Michalek007/CurrentSensingCircuit/Dokumentacja/schematics/LPF.tex

\begin{subfigure}{\textwidth}
    \hspace{4.5cm}
    \begin{tikzpicture}
        \draw
            (0, 0) node[op amp](amp1){}
            (amp1.up) to[short, -o] ++ (0, 0.5) node[above]{$3.3\ V$}
            (amp1.down) node[ground]{}

            (amp1.out) |-  ++ (0, 3) to[R, l=$R_2$, a=$100\ k\Omega$] ++ (-2, 0) -| (amp1.-)
            (amp1.out) ++ (-2.38, 3) to[R, l=$R_3$, a=$10k$, *-] ++ (-2, 0) node[ground]{}
            
            (amp1.+) to[short, -o] ++ (-1, 0) node[above]{$V_{IN}$}
            % (amp1.out) to[short, *-o] ++ (1, 0) node[above]{$V_{CMOUT}$}
            (amp1.out) to[R, l=$R_1$, a=$50\ \Omega$, *-] ++ (2, 0) coordinate(Vout) to[short, *-o] ++ (3, 0) node[above]{$V_{OUT}$}
            (Vout) to[C, l=$C_1$, a=$10\ nF$] ++ (0, -2) node[ground]{}
            (Vout) ++ (2, 0) to[R, l=$R_4$, a=$510$, *-] ++ (0, -2) node[ground]{}
        ;
    \end{tikzpicture}
\end{subfigure}
