Michalek007/CurrentSensingCircuit/Dokumentacja/schematics/wzmacniacz_pomiarowy.tex

\begin{subfigure}{\textwidth}
    \hspace{3cm}
    \begin{tikzpicture}
        \draw
            (0, 0) node[op amp, scale = 2](amp){} node[]{INA333}
            (amp) ++ (-1.66, -0.5) -- ++ (-1.22, 0) to[/tikz/circuitikz/bipoles/length=30pt, R, l=$R_G$, a=$1\ k\Omega$] ++ (0, 1) -- ++ (1.22, 0)
            (amp.up) to[short, -o] ++ (0, 0.5) node[above]{$3.3\ V$}
            (amp.down) node[ground]{}
            (amp.+) -- ++ (-2.75, 0) to[R, l=$R_{meas}$, a=$100\ \Omega$] ++ (0, 1.96)
            (amp.-) -- ++ (-2.75, 0)
            (amp.+) ++ (-2.75, 0) to[short, *-o] ++ (0, -0.5) node[below]{$In_+$}
            (amp.-) ++ (-2.75, 0) to[short, *-o] ++ (0, 0.5) node[above]{$In_-$}
            % (amp.+) ++ (-2.75, 0) to[short, *-o] ++ (-0.5, 0) node[left]{$V_{CM}$}

            (amp) ++ (1, -0.4) to[short, -o] ++ (0, -1) node[below]{$V_{REF+N}$}
            (amp.out) to[short, -o] ++ (1, 0) node[above]{$V_{out}$}

            % (amp.+) ++ (-1, -2) node[below]{$V_{REF+N}$} to[R, o-*, l=$R_1$, a=$10\ M\Omega$] ++ (0, 2) 
        ;
    \end{tikzpicture}
\end{subfigure}
