Michalek007/CurrentSensingCircuit/Dokumentacja/schematics/PSU.tex

\begin{subfigure}{\textwidth}
    \hspace{4cm}
    \begin{tikzpicture}
    \draw
        (0, 0) node[draw, rectangle, minimum width = 3cm, minimum height = 2cm, label = {above:LT1117-3.3}](U1){}
        (U1.west) node[right=1mm] {IN}
        (U1.east) node[left=1mm] {OUT}
        (U1.south) node[above=1mm] {GND}
        (U1.south) node[ground]{}

        (U1.west) -- ++(-2,0) coordinate(IN)
        to[C, l=$C_{1}$, a=$10\ \mu$F] (IN |- U1.south) node[ground] {}
        (IN) to[short, *-o] ++ (-1, 0) node[above]{$5V$}

        (U1.east) -- ++(2,0) coordinate(OUT)
        to[C, l=$C_{2}$, a=$100\ \mu$F] (OUT |- U1.south) node[ground] {}
        (OUT) to[short, *-o] ++ (1, 0) node[above]{$3.3V$}

        ;
    \end{tikzpicture}
\end{subfigure}
