Michalek007/CurrentSensingCircuit/Dokumentacja/schematics/BlockDiagramFinal.tex

\begin{subfigure}{\textwidth}
    \hspace{0cm}
    \begin{tikzpicture}
        \draw
            (0, 0) node[op amp](amp1){}
            (0, -3) node[draw, rectangle, minimum width = 2cm, minimum height = 2cm, label = {[align = center]center:$V_{REF}$ and \\ noise gen}](REF){}
            % (3, -3) node[draw, rectangle, minimum width = 2cm, minimum height = 2cm, label = {[align = center]center:Noise \\Gen}]{}
            % (5.5, -1) node[adder] (add) {}
            (4.5, 0) node[draw, rectangle, minimum width = 2cm, minimum height = 2cm, label = {[align = center]center:LPF}](LPF){}
            (9, 0) node[draw, rectangle, minimum width = 3cm, minimum height = 5cm, label = {[align = center]center:MCU}](MCU){}
            (9, -5) node[draw, rectangle, minimum width = 2cm, minimum height = 2cm, label = {[align = center]center:USB}](USB){}
            (4, -5) node[draw, rectangle, minimum width = 2cm, minimum height = 2cm, label = {[align = center]center:PSU}](PSU){}
            % (add.135) ++ (-1, 1) -- ++ (0.5, 0) -- (add)
            % (add.225) ++ (-1.15, -1) -- ++ (0.5, 0) -- (add) 
            % (add) -- ++ (1, 0)

            (amp1) ++ (0.3, -0.3) -- ++ (0, -1.7)
            (LPF) ++ (-1, 0) -- (amp1.out)
            (amp1.+) -- ++ (-1, 0) to[/tikz/circuitikz/bipoles/length=20pt, R, l=$R_{meas}$] ++ (0, 1)
            (amp1.-) -- ++ (-1, 0) to[short, *-o] ++ (0, 1) node[above]{$in-$}
            (amp1.+) ++ (-1, 0) to[short, *-o] ++ (0, -1) node[below]{$in+$}
            (LPF) ++ (1, 0) -- ++ (2, 0) ++ (-0.75, 0) node[above]{$ADC_{in}$}
            (USB) ++ (0.5, 1) -- ++ (0, 1.5) ++ (0, -0.75) node[right]{$D-$}
            (USB) ++ (-0.5, 1) -- ++ (0, 1.5) ++ (0, -0.75) node[left]{$D+$}
            (PSU) ++ (1, 0) -- ++ (3, 0) ++ (-1, 0) node[above]{$+5\ V$}
            (PSU) ++ (-1, 0) to[short, -o] ++ (-1, 0) node[above]{$+3.3\ V$}
        ;
            % wzmacniacz pomiarowy, zrodlo ref, generacja szumu, sumator, MCU, USB, PSU, LPF
    \end{tikzpicture}
\end{subfigure}
