Michalek007/CurrentSensingCircuit/Dokumentacja/schematics/Vref_gen.tex

\begin{subfigure}{\textwidth}
    \hspace{0.5cm}
    \begin{tikzpicture}
        \draw
            (0, 0) node[op amp](amp){}
            (amp.up) to[short, -o] ++ (0, 0.5) node[above]{$3.3\ V$}
            (amp.down) node[ground]{}
            (amp.-) -| ++ (-0.5, 1.5) -| ++ (2.98, -2)
            (amp.out) -- ++ (0.1, 0) to[short, *-o] ++ (1, 0) node[above]{$V_{REF}$}
            % (amp.out) ++ (0.1, -3) node[ground]{} to[C, l=$C_1$, a=$100\ nF$] ++ (0, 2) -- ++ (0, 1)
            (amp.+) -- ++ (-9, 0) ++ (0, -2) node[ground]{} to[C, l=$C_2$, a=$100\ nF$] ++ (0, 2)
            (amp.+) ++ (-6, -2) node[ground]{} to[C, -*, l=$C_3$, a=$1\ \mu F$] ++ (0, 2)
            (amp.+) ++ (-3, -2) node[ground]{} to[R, -*, l=$R_2$, a=$10\ k\Omega$] ++ (0, 2)
            to[R, -o, l=$R_1$, a=$10\ k\Omega$] ++ (0, 2) node[above]{$3.3\ V$}
        ;
    \end{tikzpicture}
\end{subfigure}

% usunac cap ma wyjsciu op-ampa
