Michalek007/CurrentSensingCircuit/Dokumentacja/schematics/Sumator.tex

\begin{subfigure}{\textwidth}
    \hspace{3cm}
    \begin{tikzpicture}
        \draw
            (0, 0) node[op amp, scale = 2](amp){}
            (amp.up) to[short, -o] ++ (0, 0.5) node[above]{$3.3\ V$}
            (amp.down) node[ground]{}
            
            (amp.+) to[R, l=$R_{4}$, a=$1.2\ k\Omega$] ++ (-2, 0) to[short, -o] ++ (0, 0.5) node[above]{$3.3\ V$} 
            (amp.+) ++ (0, -2.5) node[ground]{} to[R, -*, l=$R_{5}$, a=$1k$] ++ (0, 2.5)
            
            (amp.-) to[R, -o, l=$R_{3}$] ++ (-5.2, 0) node[above]{$V_{noise}$}

            (amp.out) to[short, *-] ++ (0, 3) to[R, l=$R_{2}$, a=$10k$] ++ (-5, 0) coordinate(test)
            to[R, l=$R_{1}$, a=$10k$] ++ (-5, 0) to[short, -o] ++ (0, 0) node[above]{$V_{in}$}
            (test) to[short, *-*] ++ (0, -2)
            (amp.out) to[short, -o] ++ (1, 0) node[above]{$V_{out}$}
        ;
    \end{tikzpicture}
\end{subfigure}
