Michalek007/CurrentSensingCircuit/Dokumentacja/chapters/schematy.tex

\section{Schematy ideowe układu}
    \begin{figure}[!ht]
        \centering
        \scalebox{1}{\input{schematics/wzmacniacz_pomiarowy.tex}}
        \caption{Schemat ideowy wzmacniacza pomiarowego.}
        \label{sch:INA333}
    \end{figure}
    \begin{figure}[!ht]
        \centering
        \scalebox{1}{\input{schematics/Vref_noise_gen.tex}}
        \caption{Schemat ideowy źródła napięcia referencyjnego z układem generacji szumu.}
        \label{sch:Vref_gen}
    \end{figure}
    % \begin{figure}[!ht]
    %     \centering
    %     \scalebox{1}{\input{schematics/Vcm_measure.tex}}
    %     \caption{Schemat do pomiaru napięcia sumacyjnego.}
    %     \label{sch:VCM_measure}
    % \end{figure}
    % \clearpage
    \begin{figure}[!ht]
        \centering
        \scalebox{1}{\input{schematics/LPF.tex}}
        \caption{Schemat pasywnego filtru RC o częstotliwości granicznej $f_g \approx 318\ kHz$.}
        \label{sch:LPF}
    \end{figure}
    % \begin{figure}[!ht]
    %     \centering
    %     \scalebox{1}{\input{schematics/Noise_gen.tex}}
    %     \caption{Schemat układu generacji szumu białego.}
    %     \label{sch:Noise_gen}
    % \end{figure}
    % \begin{figure}[!ht]
    %     \centering
    %     \scalebox{1}{\input{schematics/Sumator.tex}}
    %     \caption{Układ sumacyjny dla dodania sygnału pomiarowego i szumu.}
    %     \label{sch:sumator}
    % \end{figure}
    \begin{figure}[!ht]
        \centering
        \scalebox{1}{\input{schematics/PSU.tex}}
        \caption{Układ stabilizacji napięcia na 3.3V. }
        \label{sch:psu}
    \end{figure}
