Michalek007/CurrentSensingCircuit/Dokumentacja/main.pdf

# Akademia Górniczo-Hutnicza im. Stanisława Staszica w Krakowie

# Dokumentacja projektu

# Układ do pomiaru natężenia prądu poniżej jednego LSB przetwornika A/C

z przedmiotu

# Analogowe układy peryferyjne w systemach cyfrowych

Elektronika i telekomunikacja - Systemy wbudowane, rok II studiów magisterskich

### Piotr Kowol, Piotr Mosurek, Michał Nizioł

### 12 listopada 2025

## Spis treści

1 Wstęp | 2
1.1 Założenia | | 2
1.2 Schemat Blokowy | | 2
2 Schematy ideowe układu | 3
3 Symulacje układów | 4

## Spis rysunków

1.1 Schemat blokowy układu do pomiaru natężenia prądu | | 2
2.1 Schemat ideowy wzmacniacza pomiarowego | | 3
2.2 Schemat ideowy źródła napięcia referencyjnego z układem generacji szumu. . . . | 3
2.3 Schemat pasywnego filtru RC o częstotliwości granicznej fg ≈ 318 kHz | | 3
2.4 Układ stabilizacji napięcia na 3.3V | | 3
3.1 Symulacja tran stabilizatora napięcia LM1117-3.3 napięcia wejściowego (Vin) i
wyjściowego (Vout) | | 4
3.2 Symulacja parametryczna wzmacniacza pomiarowego w zakresie ±1 µA | | 5
3.3 Symulacja parametryczna wzmacniacza pomiarowego w zakresie ±100 nA. . . . | 5
3.4 Symulacja dc wejściowego napięcia wspólnego wzmacniacza pomiarowego dla
Imeas = 1 µA, różnica napięć ≈ 65 µV | | 6
3.5 Wzmocnie różnicowe INA333 | | 6
3.6 Wzmocnienie od wejścia REF wzmacniacza pomiarowego | | 7
3.7 Charakterystyki częstotliwościowe układu: czerwona - pasmo przenoszenia generatora szumu, zielona - pasmo przenoszenia na wyjściu INA333, niebieska -pasmo przenoszenia za filtrem LPF z wtórnikiem - UWAGA, bez wtónika jest
podbicie o ≈ 7 dB na wyjściu INA333 przy f ≈ 150 kHz | 7
3.8 Transformata fouriera z 10 ms symulacji transient wzmacniacza pomiarowego z generacją szumu na referencji. Okno fft 100 Hz, co daje ≈ 1.65 √

µV
Hz | 8

## 1. Wstęp

### 1.1. Założenia

| Pomiar prądu rzędu 10 nA,
| Wykorzystanie ditheringu szumem Gaussowskim,
| Wykorzystanie mikroprocesora STM32F103C8T6 z 12 bitowym ADC,
| Wykorzystanie wzmacniacza pomiarowego INA333.

### 1.2. Schemat Blokowy

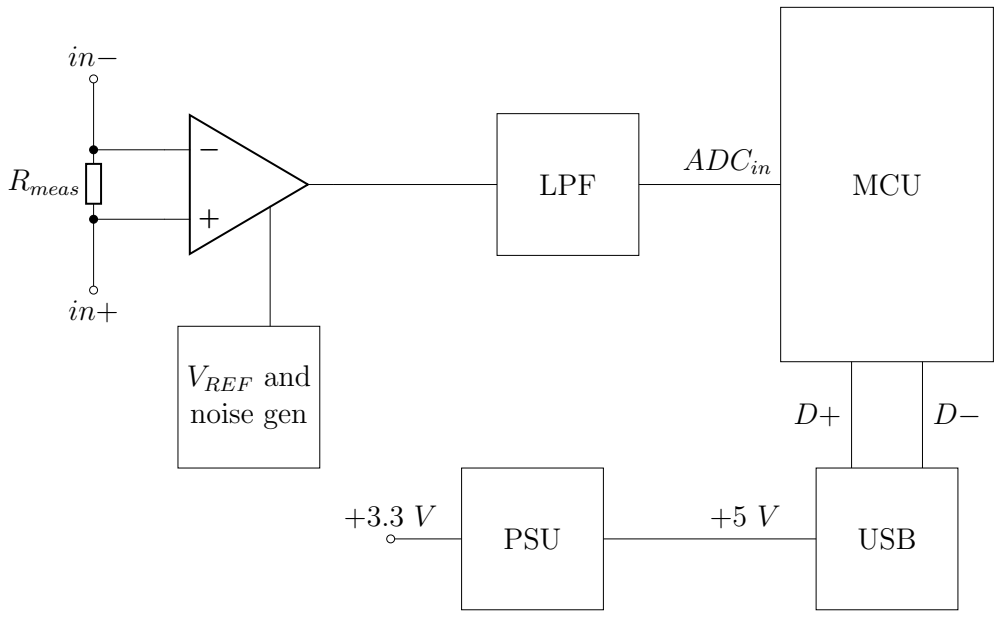
[picture p2: figure]
VREF and noise gen; LPF; MCU; PSU; USB; Rmeas; ADCin

Rysunek 1.1: Schemat blokowy układu do pomiaru natężenia prądu.

## 2. Schematy ideowe układu

−

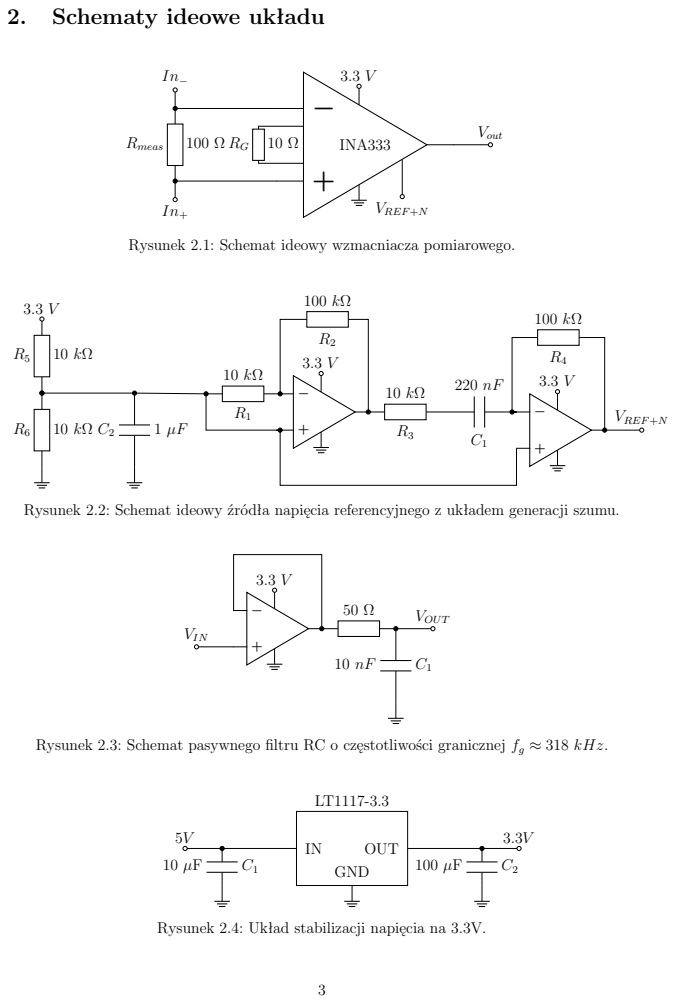
[picture p3: page 4]

Rysunek 2.1: Schemat ideowy wzmacniacza pomiarowego.

Rysunek 2.2: Schemat ideowy źródła napięcia referencyjnego z układem generacji szumu.

Rysunek 2.3: Schemat pasywnego filtru RC o częstotliwości granicznej fg ≈ 318 kHz.

Rysunek 2.4: Układ stabilizacji napięcia na 3.3V.

## 3. Symulacje układów

Podczas symulacji sprawdzono działanie kilku bloków funkcjonalnych, tj. PSU, generator szumu białego oraz wzmacniacz pomiarowy. Symulacja czasowa PSU pozwoliła sprawdzić jak duży będzie przerzut napięcia podczas uruchomiania układu. Wyniki przedstawiono na rysunku 3.1.

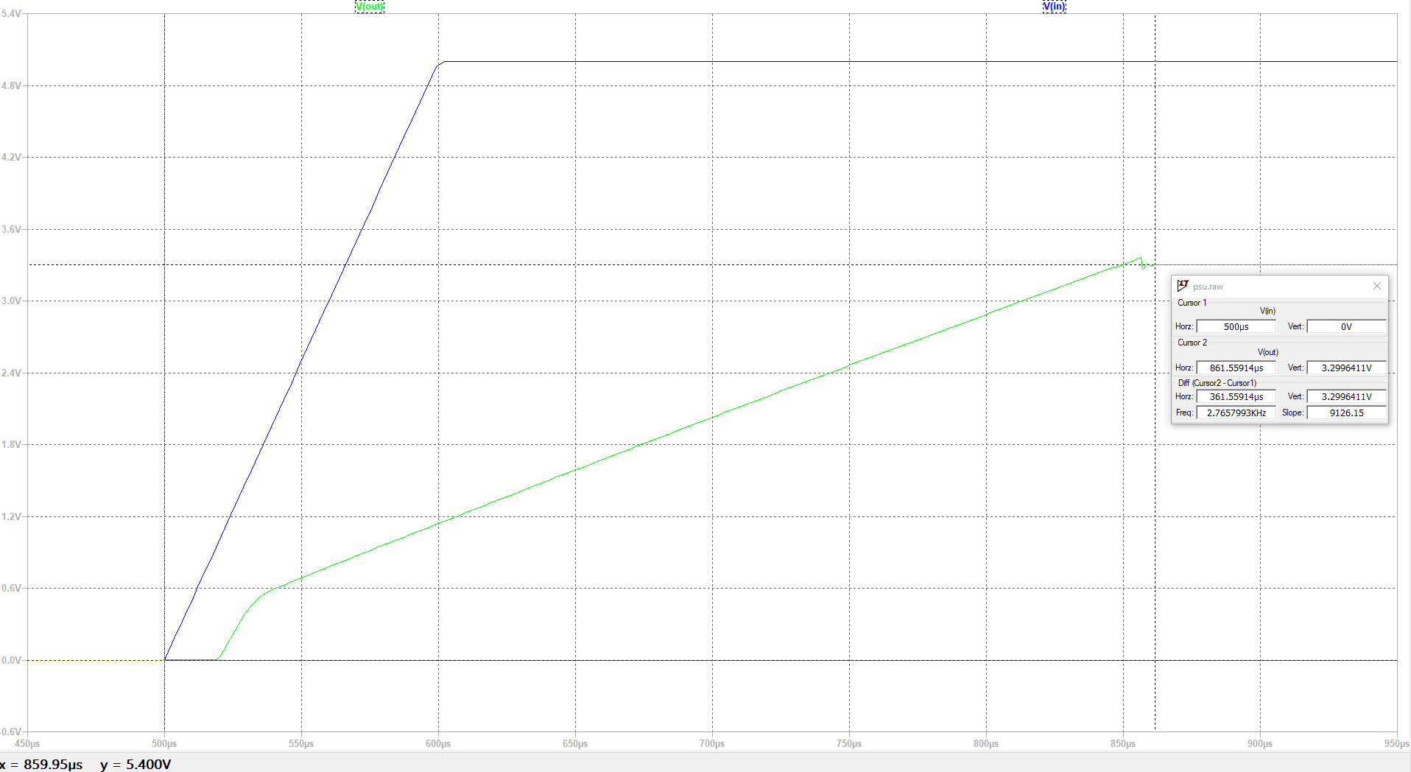
[picture p4: figure]

Rysunek 3.1: Symulacja tran stabilizatora napięcia LM1117-3.3 napięcia wejściowego (Vin) i wyjściowego (Vout).

Podczas symulacji wzmacniacza pomiarowego okazało się, że możliwe będzie zmierzenie prądów o natężeniu 1 nA. Czułość wzmacniacza określono na 1 mV
1 nA . Zakres pomiarowy wynosi ±1 µA, a dopuszczalny zakres napięcia wspólnego, przy maksymalnym prądzie wynosi ≈ 0.7 V ÷ ≈ 2.8 V . Zależność napięcia wyjściowego od prądu wejściowego przedstawiono na wykresach 3.3 i 3.2. Zależność napięcia wyjściowego od wejściowego napięcia wspólnego dla prądu 1 µA została przedstawiona na wykresie 3.4.
parametr | wartość | komentarz
czułość | mV 1 nA | czułość układu bez ditheringu
zakres pomiarowy | ±1 µA | -
zakres napięcia wspólnego | 0.7 ÷ 2.8 V | -
częstotliwość graniczna | 30 Hz | ograniczenie od INA333
pasmo szumu białego | 100 Hz ÷ 200 kHz | górne ograniczenie od wejścia REF INA333
napięcie szumu | ≈ 0.74 mV | w paśmie 100 Hz ÷ 200 kHz
widmowa gęstość szumu | ≈ 1.65 √ µV Hz | -
częstotliwość próbkowania | fS = 1 MHz | z dokumentacji STM32F103C8T6
częstotliwość nadpróbkowania | fOV S = 62.5 kHz | nadpróbkowanie 16 razy
dodatkowe bity | +2 bity | na podstawie AN5537
teoretyczna wartość mierzalnego | Imeas ≈ 250 pA | jeśli nie tracimy na ENOB prądu przy ditheringu

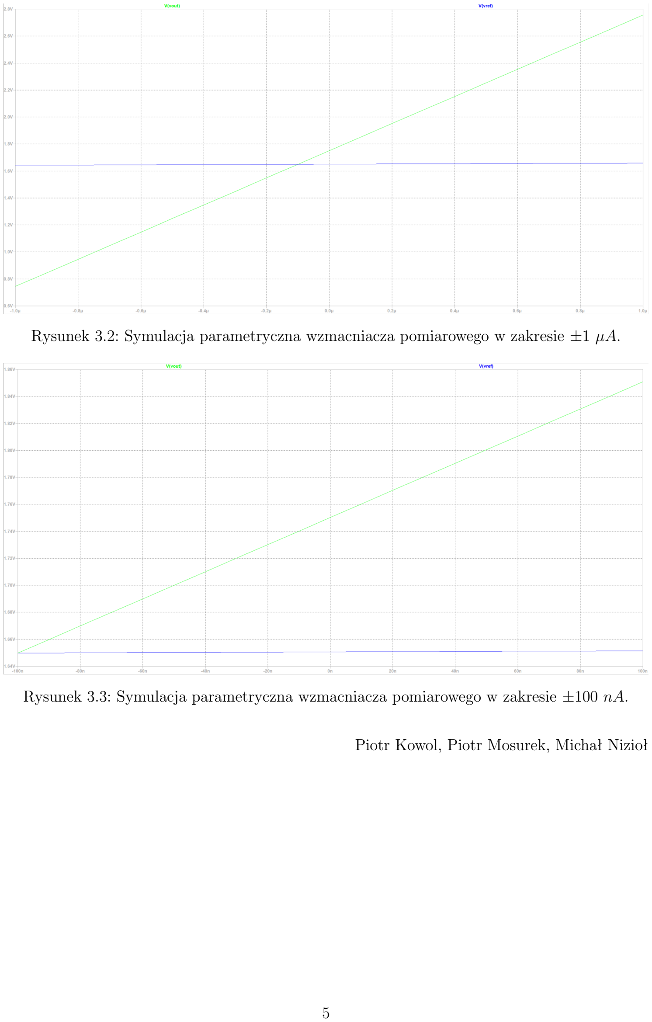
[picture p5: page 6]

Rysunek 3.2: Symulacja parametryczna wzmacniacza pomiarowego w zakresie ±1 µA.

Rysunek 3.3: Symulacja parametryczna wzmacniacza pomiarowego w zakresie ±100 nA.

Piotr Kowol, Piotr Mosurek, Michał Nizioł

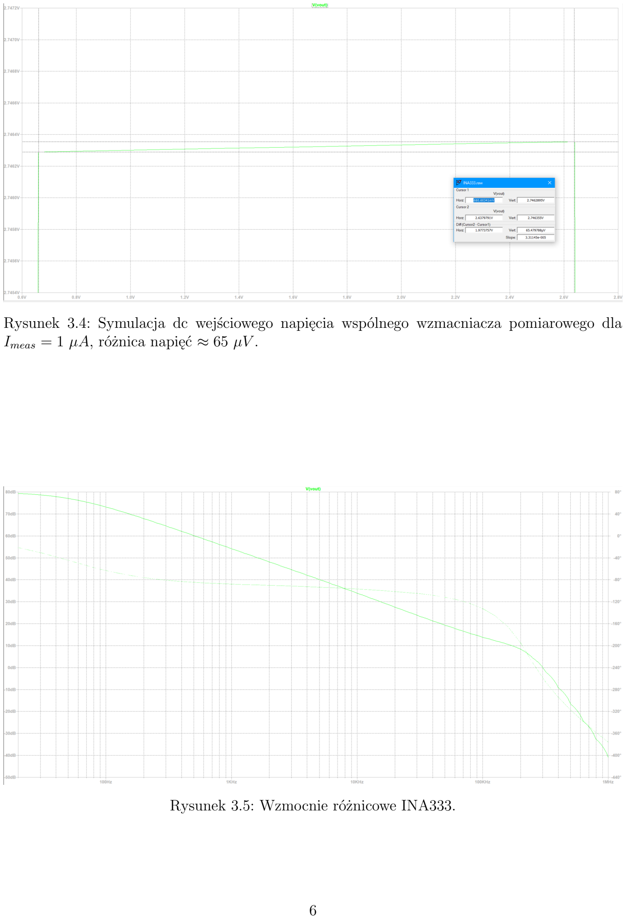
[picture p6: page 7]

Rysunek 3.4: Symulacja dc wejściowego napięcia wspólnego wzmacniacza pomiarowego dla Imeas = 1 µA, różnica napięć ≈ 65 µV .

Rysunek 3.5: Wzmocnie różnicowe INA333.

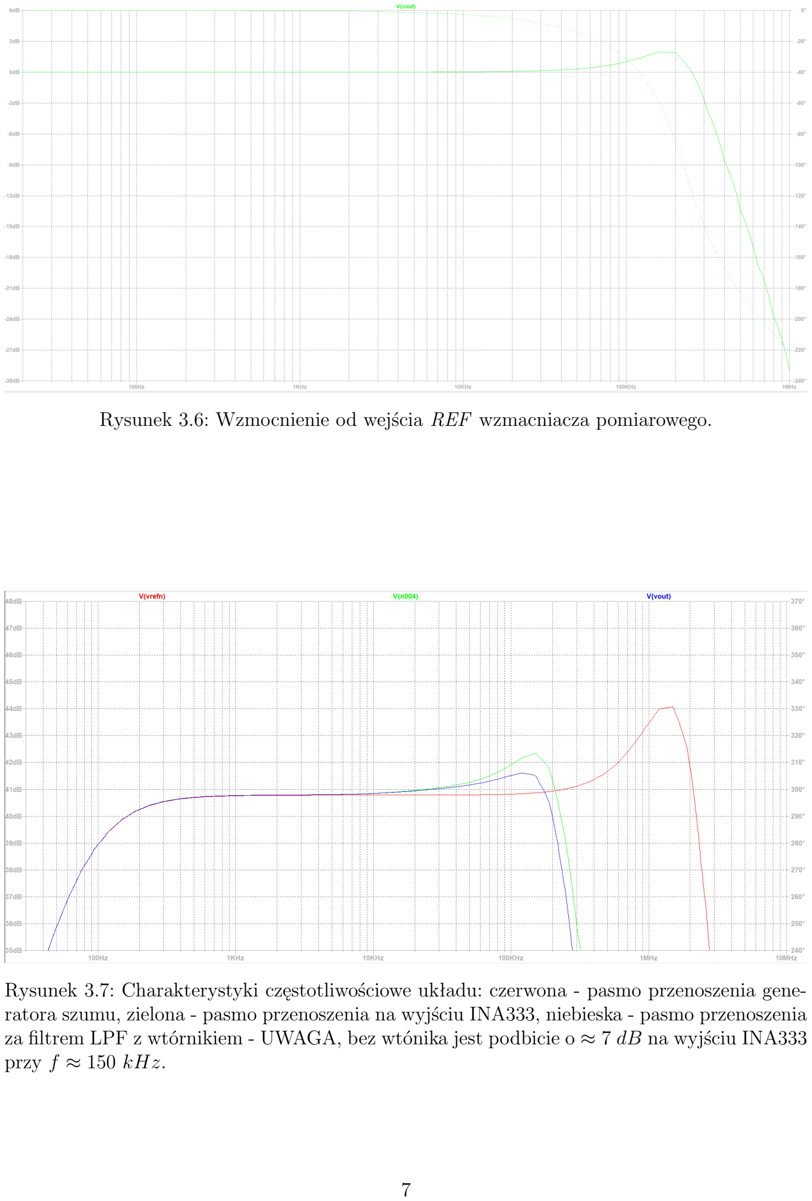
[picture p7: page 8]

Rysunek 3.6: Wzmocnienie od wejścia REF wzmacniacza pomiarowego.

Rysunek 3.7: Charakterystyki częstotliwościowe układu: czerwona - pasmo przenoszenia generatora szumu, zielona - pasmo przenoszenia na wyjściu INA333, niebieska - pasmo przenoszenia za filtrem LPF z wtórnikiem - UWAGA, bez wtónika jest podbicie o ≈ 7 dB na wyjściu INA333 przy f ≈ 150 kHz.

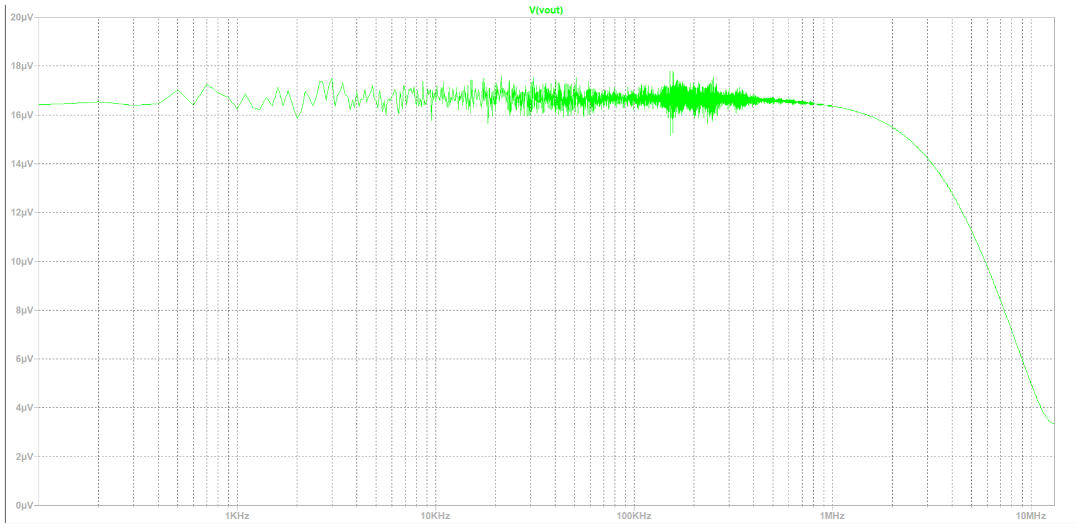
[picture p8: figure]

Rysunek 3.8: Transformata fouriera z 10 ms symulacji transient wzmacniacza pomiarowego z generacją szumu na referencji. Okno fft 100 Hz, co daje ≈ 1.65 √

µV
Hz .
