Michalek007/CurrentSensingCircuit/Raport/main.pdf

# Akademia Górniczo-Hutnicza im. Stanisława Staszica w Krakowie

# Raport z projektu

# Układ do pomiaru natężenia prądu poniżej jednego LSB przetwornika A/C

z przedmiotu

# Analogowe układy peryferyjne w systemach cyfrowych

Elektronika i telekomunikacja - Systemy wbudowane, rok II studiów magisterskich

### Piotr Kowol, Piotr Mosurek, Michał Nizioł

### 19 lutego 2026

## 1. Schematy ideowe układu

Poniżej przedstawiono schematy części analogowej układu. Podczas pomiarów okazało się, że szum INA333 jest znacznie większy od szumu generowanego przez generator szumu. W związku z tym, zredukowano szum generowany przez generator szumu oraz zmniejszono wzmocnienie INA333 z Ku = 10000 V
V

do Ku = 100 V
V

. Modyfikacja wiązała się z wlutowaniem kondensatora o wartości 1 µF w sprzężenie zwrotne wyjściowego wzmacniacza generatora szumu, co dało obcięcie pasma do około 100 Hz, oraz zmiana rezystora ustalającego wzmocnienie z 10 Ω do 1 kΩ. Wprowadzone modyfikacje pozwoliły zmniejszyć szum do około 1÷2 LSB. Schemat wzmacniacza pomiarowego przedstawiono na rysunku 1.1, a generatora szumu na rysunku 1.2. Wyjście INA333 podłączono do filtra anty-aliasing’owego, który został przedstawiony na rysunku 1.3. Rezystor R4 zgodnie z dokumentacją zastosowanego wzmacniacza pozwala zmniejszyć wpływ obciążenia pojemnościowego na wzmacniacz, ale wprowadza tłumienie sygnału, dlatego zamiast wtórnika zastosowano wzmacniacz w konfiguracji nieodwracającej o niewielkim wzmocnieniu. Parametry robocze układu przedstawiono w tabeli 1.1.

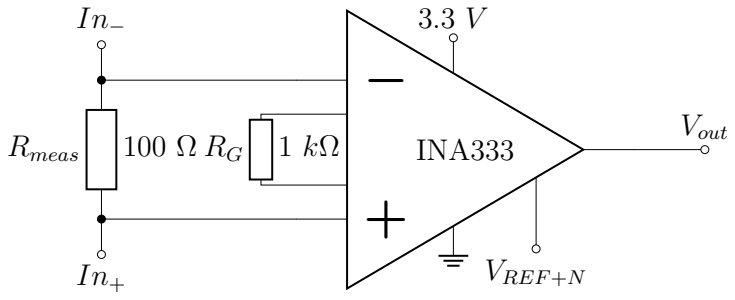
[picture p27: figure]
INA333; Rmeas; VREF +N; Vout

Rysunek 1.1: Schemat ideowy wzmacniacza pomiarowego.

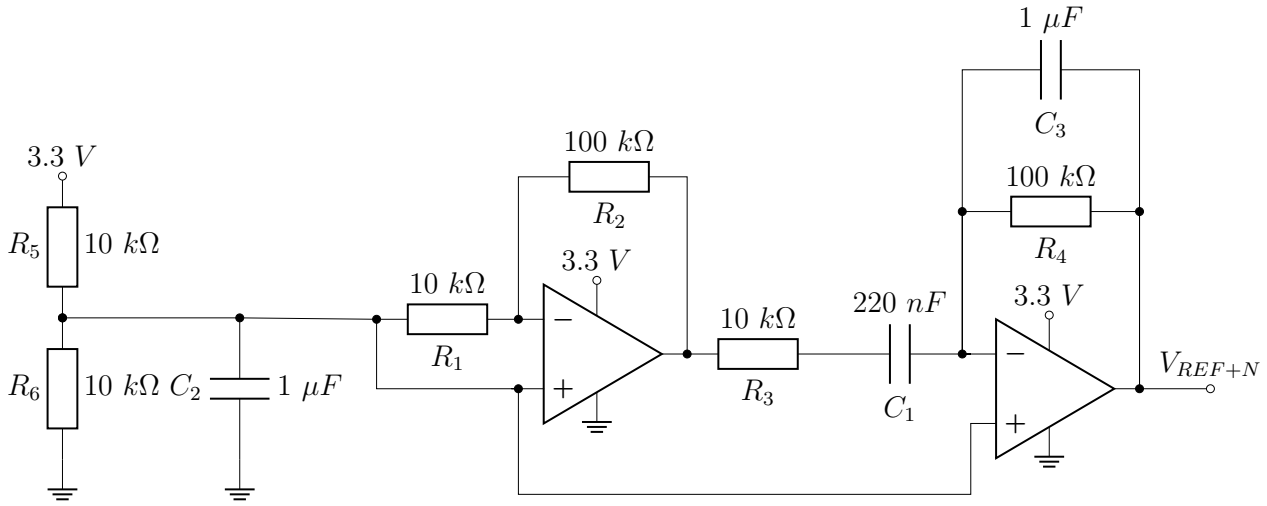
[picture p28: figure]
VREF +N

Rysunek 1.2: Schemat ideowy źródła napięcia referencyjnego z układem generacji szumu.

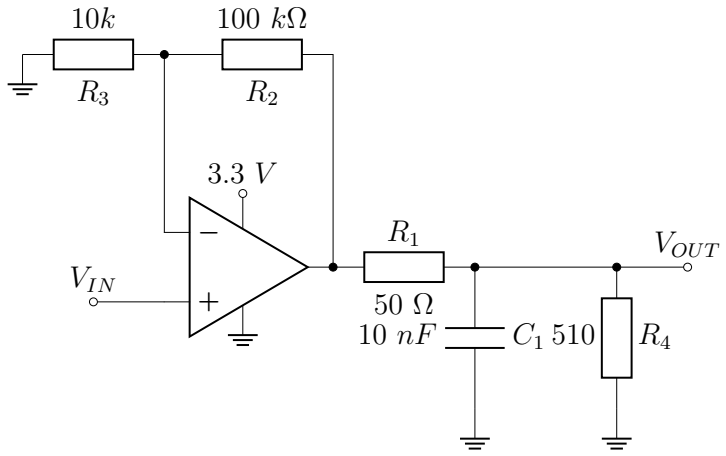
[picture p29: figure]
VIN; VOUT

Rysunek 1.3: Schemat pasywnego filtru RC o częstotliwości granicznej fg ≈ 318 kHz.

parametr | wartość | komentarz
czułość | 10 mV µA | czułość układu bez ditheringu
zakres pomiarowy | ±100 µA | -
zakres napięcia wspólnego | 0.7 ÷ 2.8 V | -
częstotliwość graniczna | 30 Hz | ograniczenie od INA333
pasmo szumu białego | 100 Hz ÷ 300 kHz
napięcie szumu | ≈ 1.5 mV | w paśmie 100 Hz ÷ 300 kHz
częstotliwość próbkowania | fS = 300 kHz | z dokumentacji STM32F103C8T6
częstotliwość nadpróbkowania | fOV S = 18.75 kHz | nadpróbkowanie 16 razy
dodatkowe bity | +2 bity | na podstawie AN5537
teoretyczna wartość mierzalnego | Imeas ≈ 25 nA | jeśli nie tracimy na ENOB prądu przy ditheringu

Tabela 1.1: Parametry zaprojektowanego układu do pomiaru prądu.

## 2. Pomiary

Podczas pomiarów wystąpiły problemy z rozkładem prawdopodobieństwa szumu - była widoczna asymetria powodowana przez układ zasilania - LDO. Asymetria była zależna od natężenia i polaryzacji prądu. Rozwiązaniem było zastosowanie zasilacza laboratoryjnego - szum był Gaussowski, do puki zasilacz się nie nagrzał - potem rozkład nieco się zniekształcił, ale znacznie mniej niż w przypadku LDO. Przebiegi czasowe oraz rozkłady prawdopodobieństwa dla kilku pomiarów przedstawiono na rysunkach 2.1 - 2.5. Dodatkowa filtracja pozwala uzyskać dokładniejsze wyniki, co zostało przedstawione na rysunku 2.6. Dodatkowym utrudnieniem w przeprowadzaniu pomiarów było występowanie zewnętrznych zakłóceń, co powodowało chwilowe zmiany napięcia wejściowego przetwornika ADC, oraz wprowadzało zniekształcenie w histogramie.
Zastosowany algorytm oblicza sumę 16 próbek, a następnie dzieli wynik przez 4, co pozwala zapisać wynik na 14 bitach zamiast 12. Tak przygotowane dane są przesyłane do komputera przez UART.

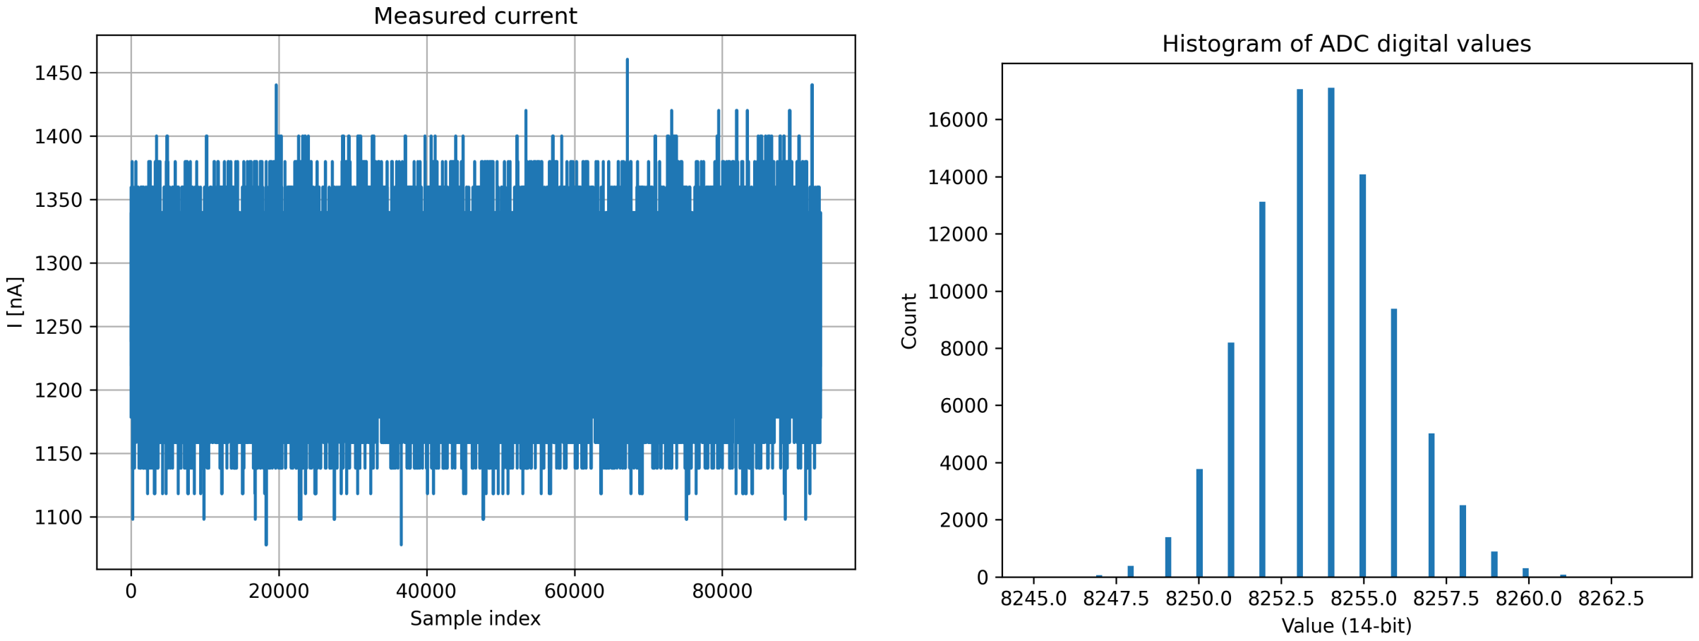
[picture p30: figure]

Rysunek 2.1: Mierzony prąd oraz rozkład prawdopodobieństwa szumu dla prądu 0 µA przy zasilaniu z LDO - nie widać zniekształceń.

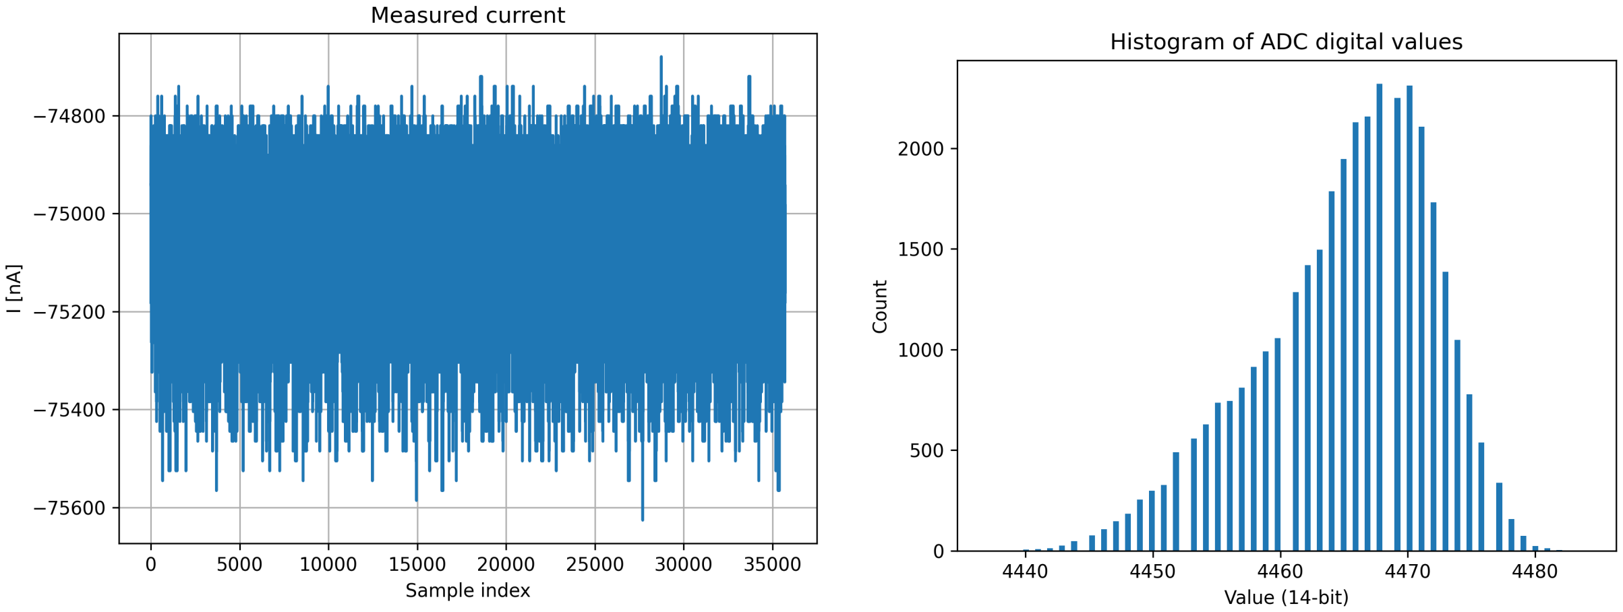
[picture p31: figure]

Rysunek 2.2: Mierzony prąd oraz rozkład prawdopodobieństwa szumu dla prądu −75 µA przy zasilaniu z LDO - odwrócona polaryzacja oraz zniekształcenie dla wyższych wartości.

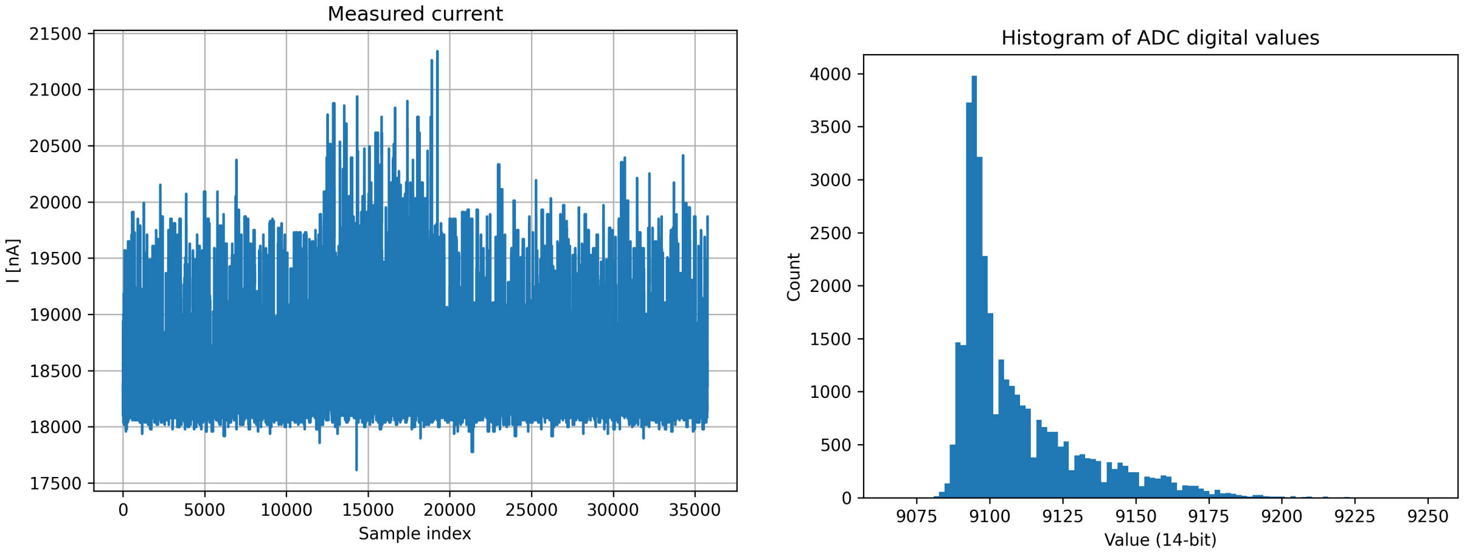
[picture p32: figure]

Rysunek 2.3: Mierzony prąd oraz rozkład prawdopodobieństwa szumu dla prądu 16 µA przy zasilaniu z LDO - zniekształcenie dla mniejszych wartości.

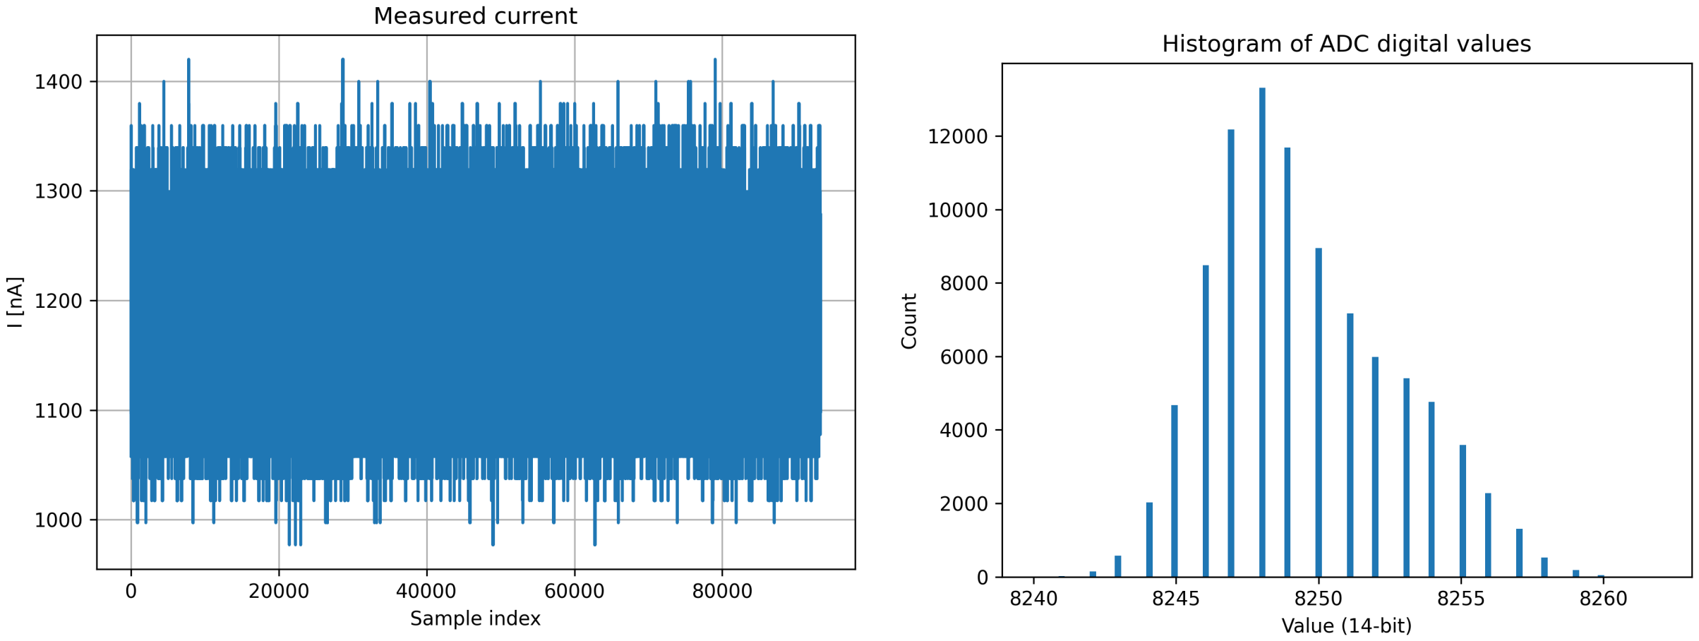
[picture p33: figure]

Rysunek 2.4: Mierzony prąd oraz rozkład prawdopodobieństwa szumu dla prądu 0 µA przy zasilaniu z zasilacza laboratoryjnego - widać niewielkie zniekształcenie, ale nie zmienne.

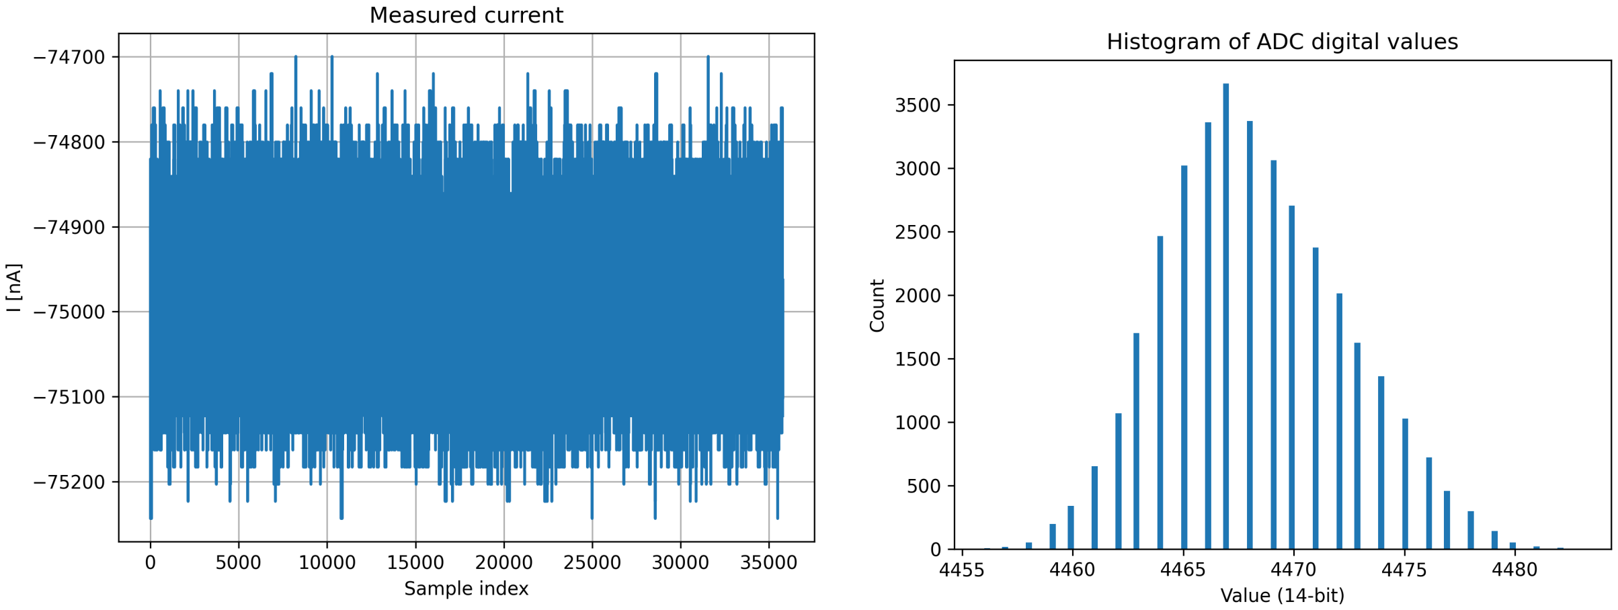
[picture p34: figure]

Rysunek 2.5: Mierzony prąd oraz rozkład prawdopodobieństwa szumu dla prądu −75 µA przy zasilaniu z zasilacza laboratoryjnego - zniekształcenie niemalże takie same jak dla zerowego prądu z zasilacza, można zauważyć zewnętrzne zakłócenie.


Rysunek 2.6: Przebieg prądu −75 µA po filtracji przy zasilaniu z zasilacza.

## 3. Podsumowanie

Mimo napotkanych problemów udało się zrealizować pomiar poniżej 1 LSB - dzięki decymacji zwiększono rozdzielczość przetwornika o 2 bity.

Piotr Kowol, Piotr Mosurek, Michał Nizioł
