Michalek007/CurrentSensingCircuit/Dokumentacja/Images/INA333_cm_sim.png

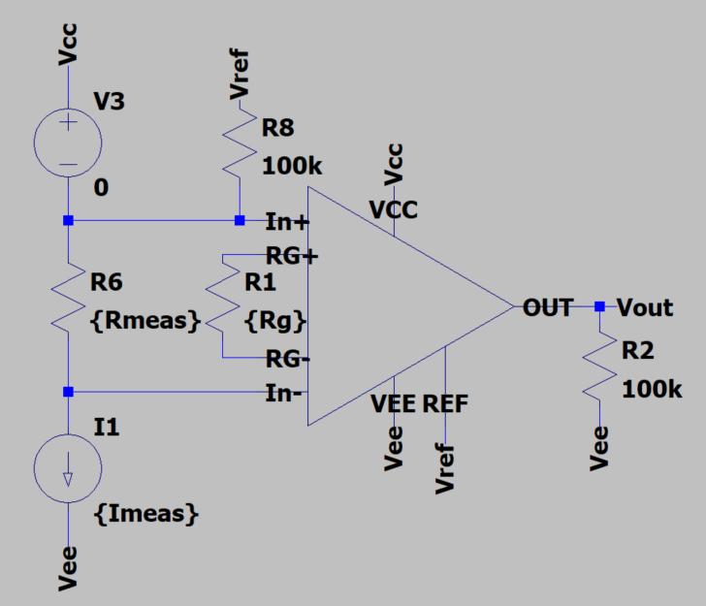
Dokumentacja/Images/INA333_cm_sim.png
