Michalek007/CurrentSensingCircuit/Dokumentacja/Images/INA333_p1u_cm.png

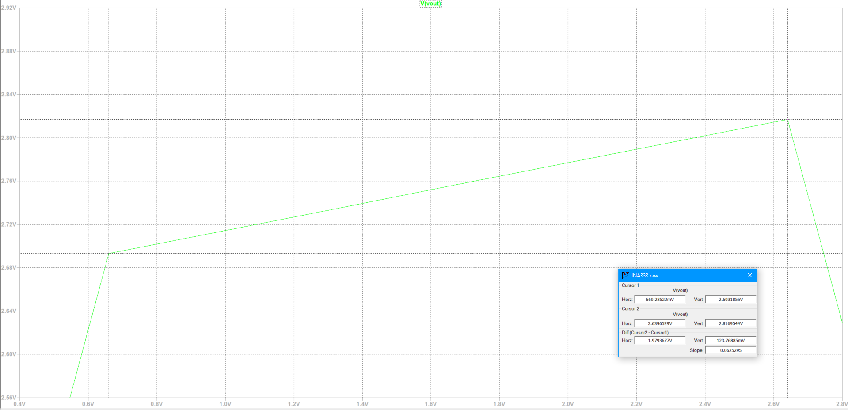
Dokumentacja/Images/INA333_p1u_cm.png
