Michalek007/CurrentSensingCircuit/Dokumentacja/Images/INA333_slope_cur.png

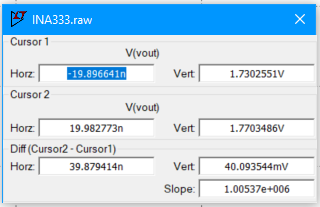
Dokumentacja/Images/INA333_slope_cur.png
