Michalek007/CurrentSensingCircuit/Dokumentacja/Images/INA_noise.png

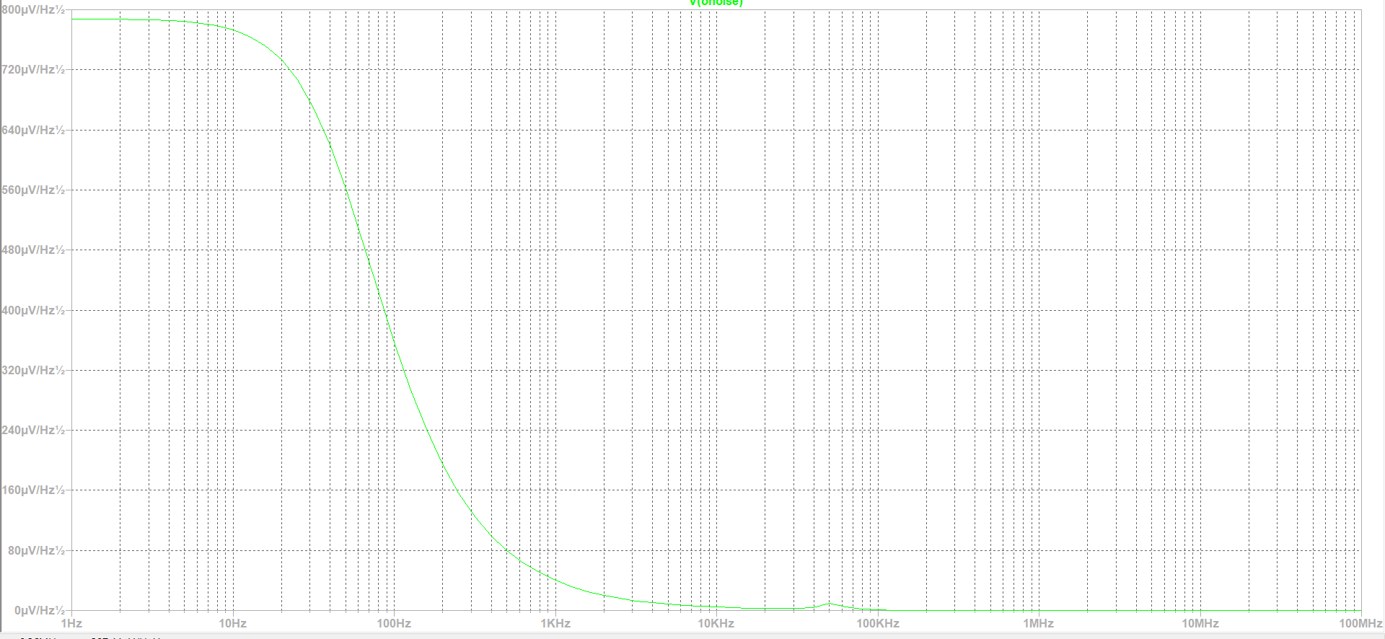
Dokumentacja/Images/INA_noise.png
