Michalek007/CurrentSensingCircuit/Dokumentacja/Images/INA_noise_gen.png

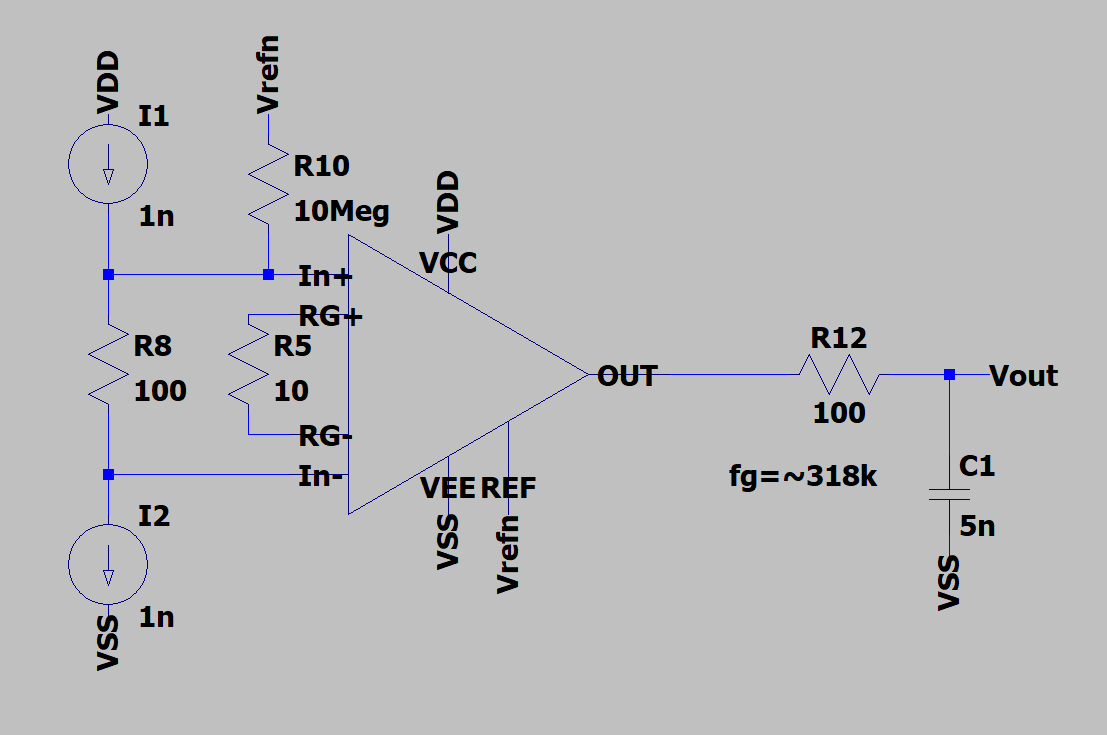
Dokumentacja/Images/INA_noise_gen.png
