Michalek007/CurrentSensingCircuit/Dokumentacja/Images/INA_noise_zoom.png

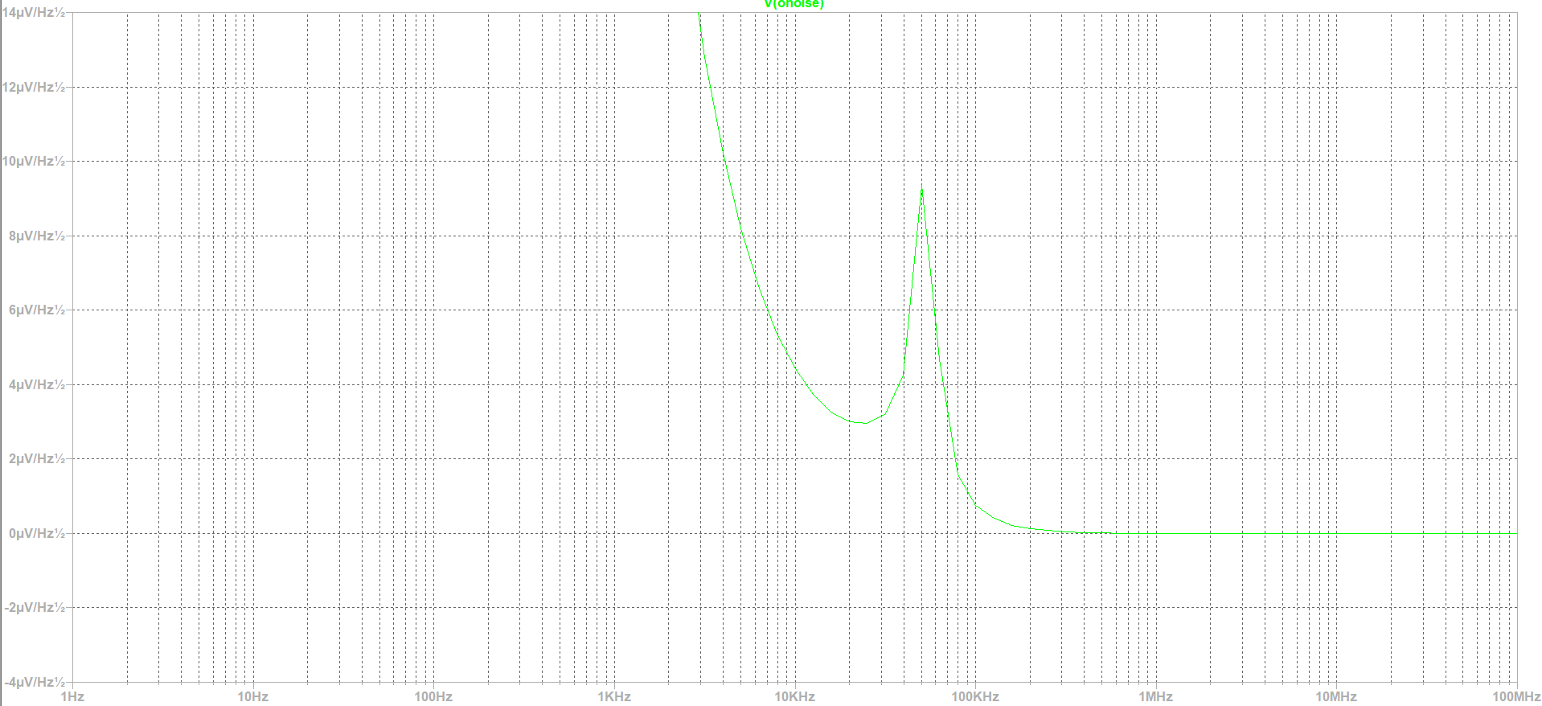
Dokumentacja/Images/INA_noise_zoom.png
