Michalek007/CurrentSensingCircuit/Dokumentacja/Images/Noise_gen_output.png

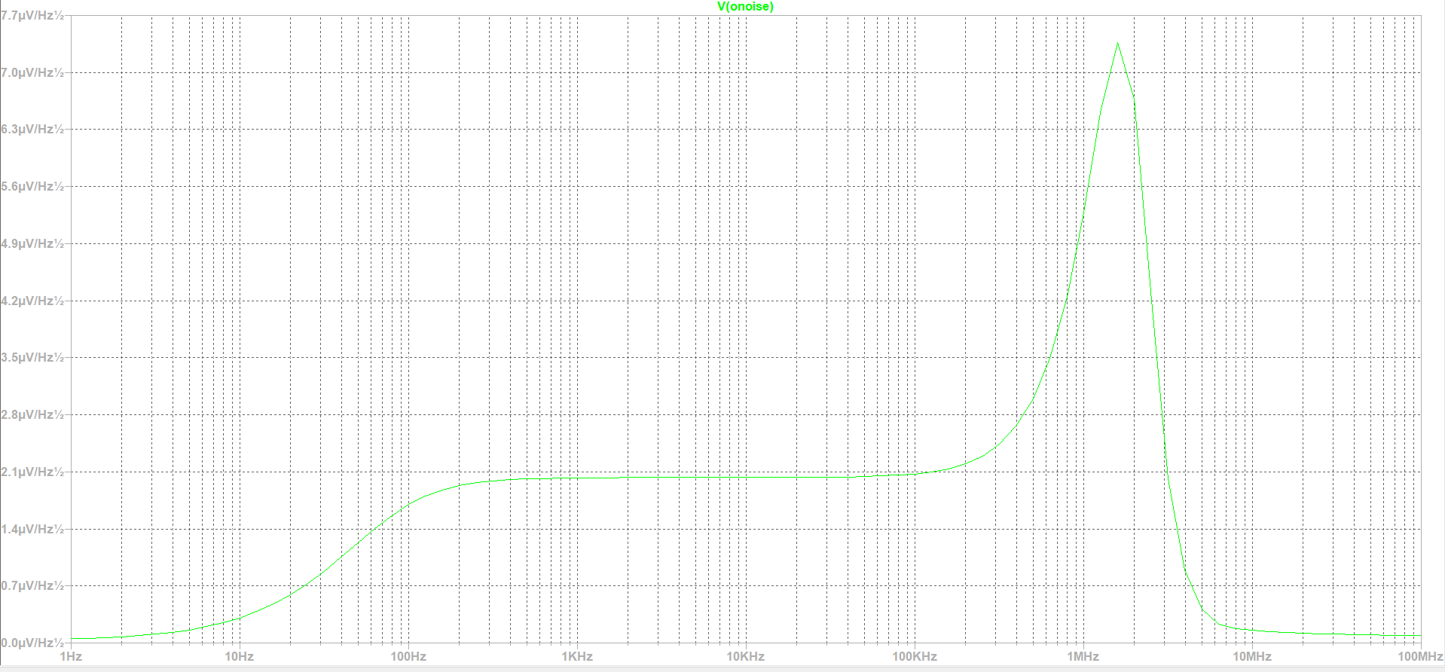
Dokumentacja/Images/Noise_gen_output.png
