Michalek007/CurrentSensingCircuit/Dokumentacja/Images/Noise_gen_sch.png

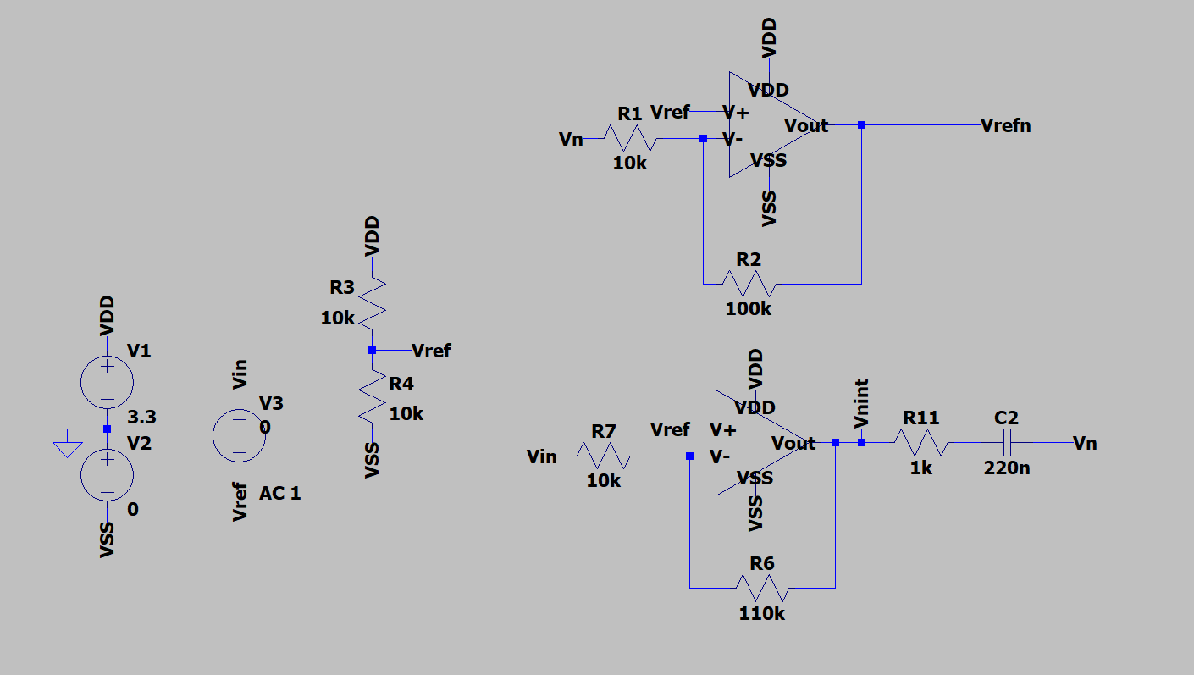
Dokumentacja/Images/Noise_gen_sch.png
