Michalek007/CurrentSensingCircuit/Dokumentacja/Images/stm32g_Vref.png

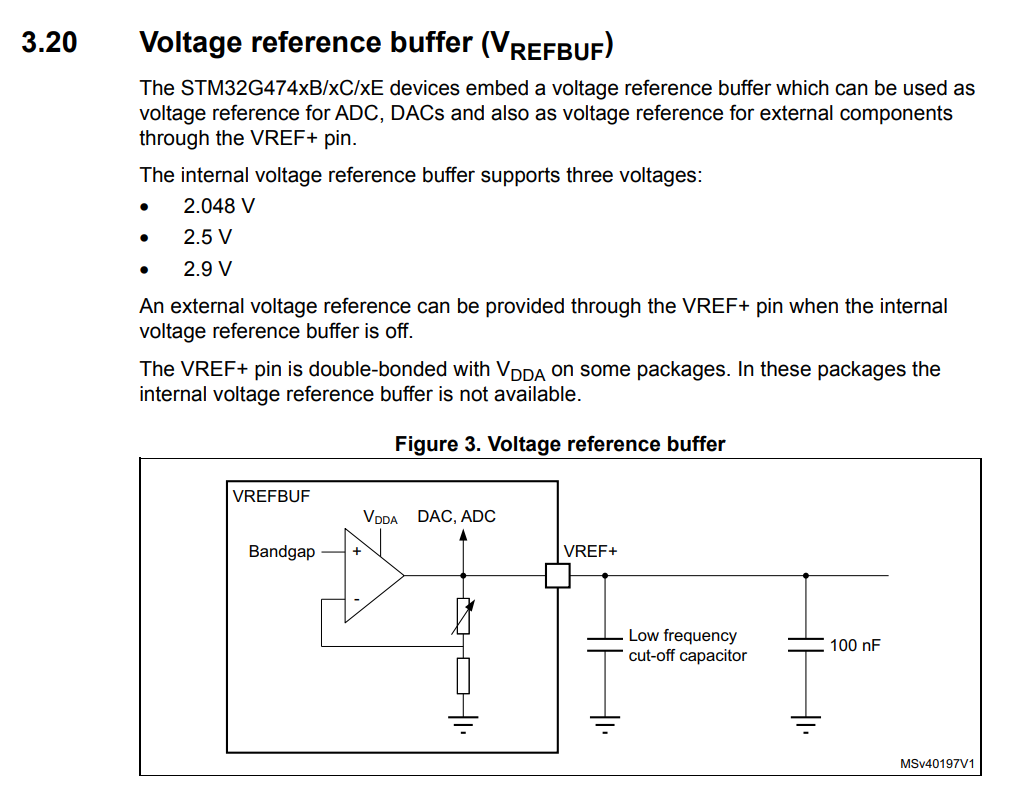
Dokumentacja/Images/stm32g_Vref.png
