Michalek007/CurrentSensingCircuit/Dokumentacja/Images/sumator_dc.png

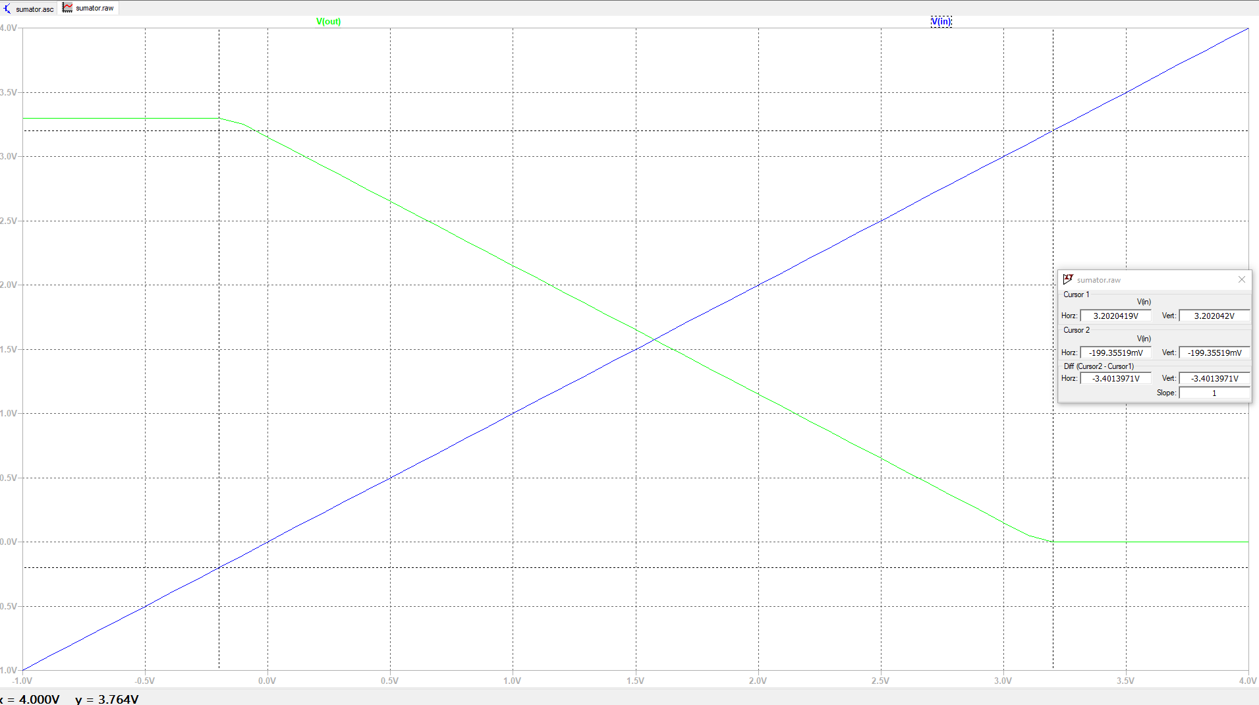
Dokumentacja/Images/sumator_dc.png
