Michalek007/CurrentSensingCircuit/Dokumentacja/Images/Vcm_sch.png

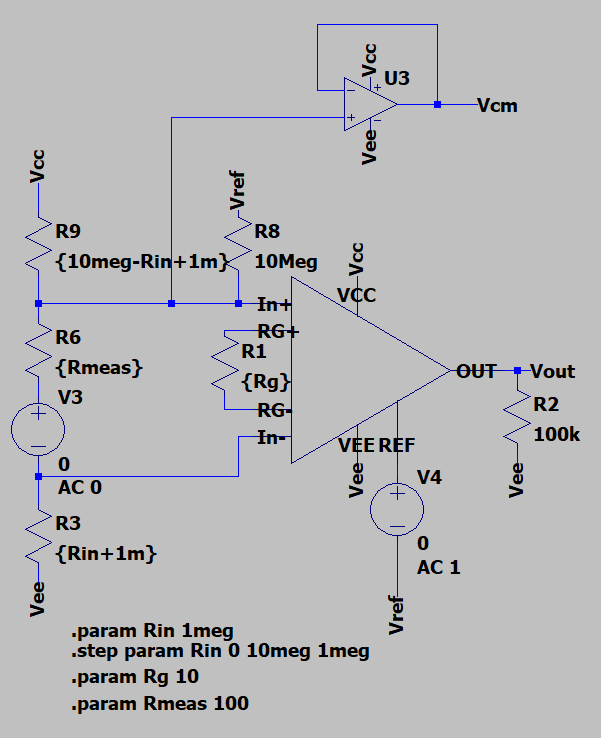
Dokumentacja/Images/Vcm_sch.png
