Michalek007/CurrentSensingCircuit/Dokumentacja/Images/Vcm_sch_v2.png

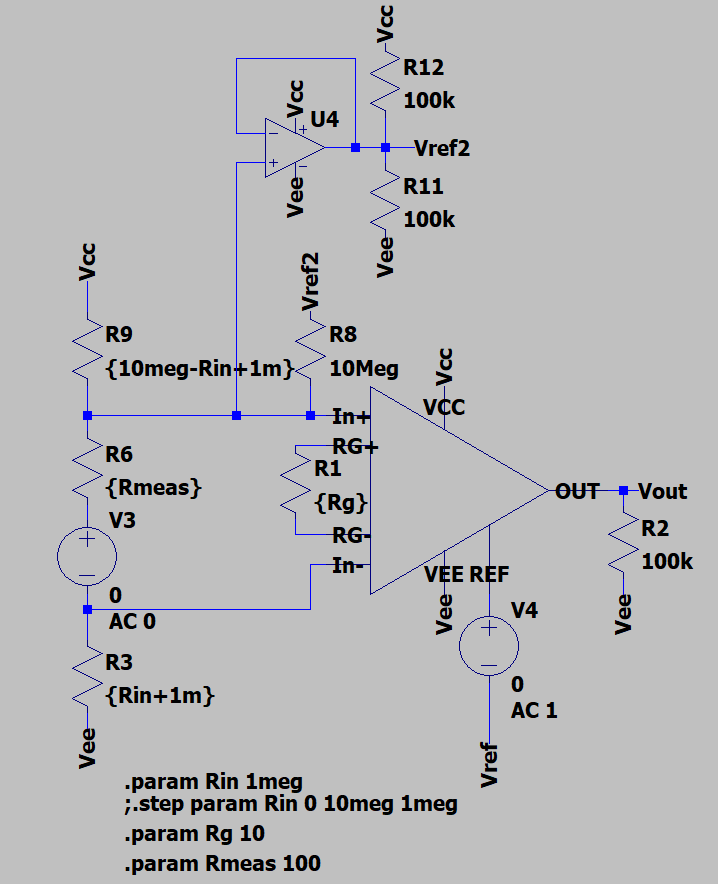
Dokumentacja/Images/Vcm_sch_v2.png
