Michalek007/CurrentSensingCircuit/Dokumentacja/Images/Vcm_sim.png

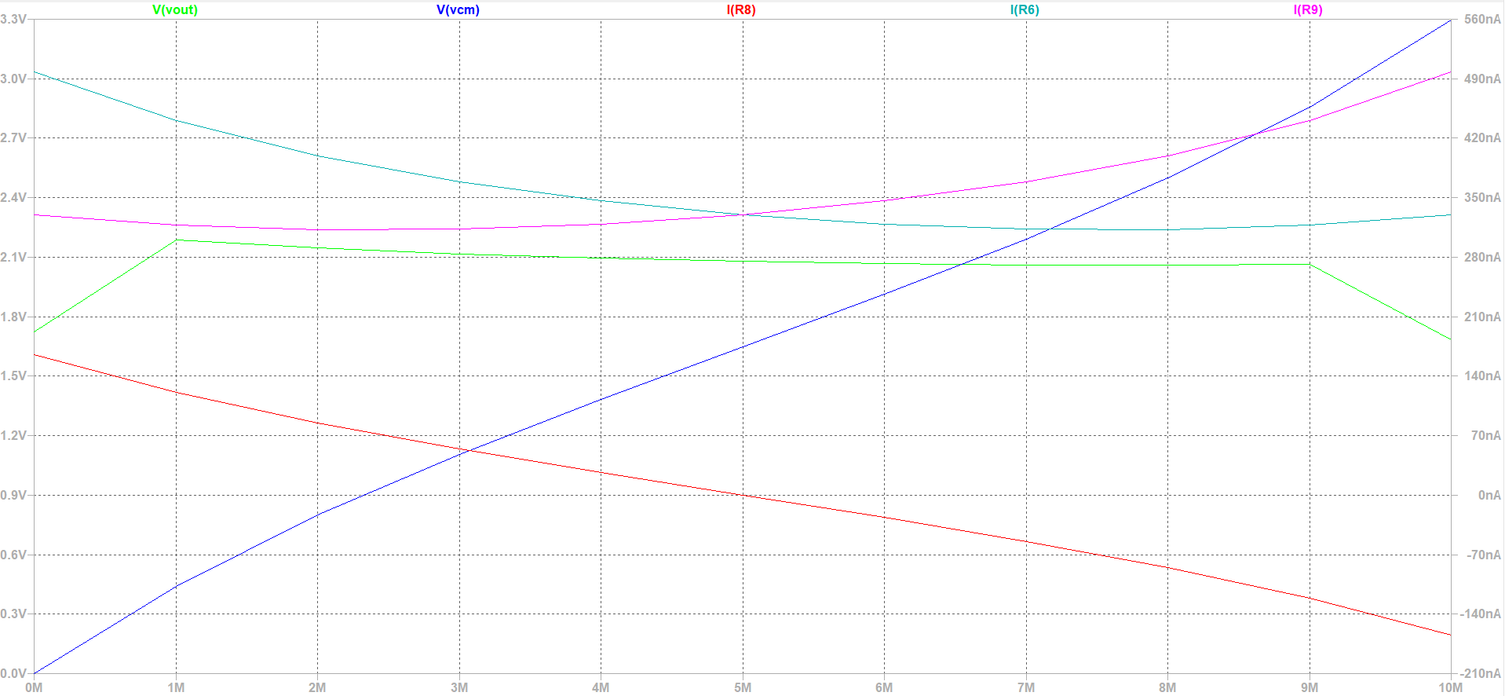
Dokumentacja/Images/Vcm_sim.png
