Michalek007/CurrentSensingCircuit/Dokumentacja/Images/Vcm_sim_v2.png

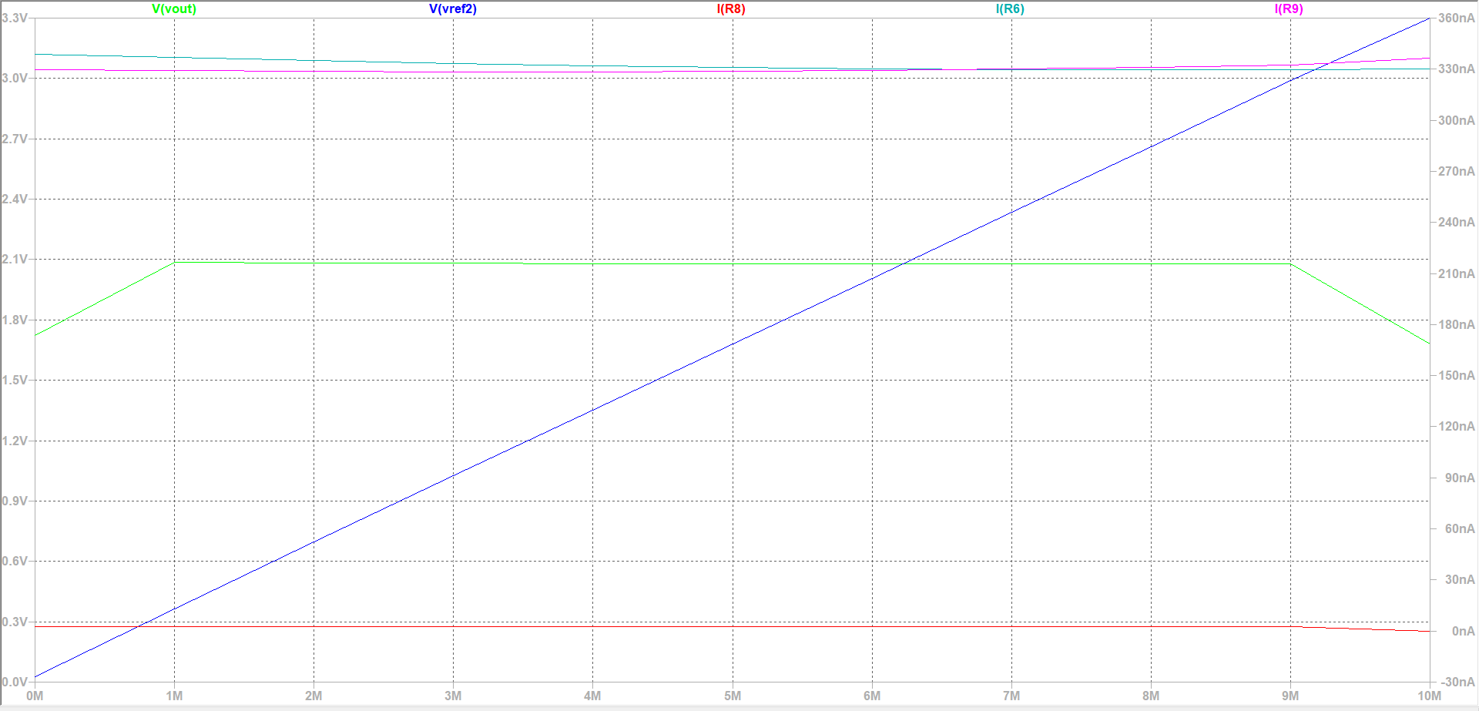
Dokumentacja/Images/Vcm_sim_v2.png
