Michalek007/CurrentSensingCircuit/Raport/Images/R0_stlink_current_filtered.png

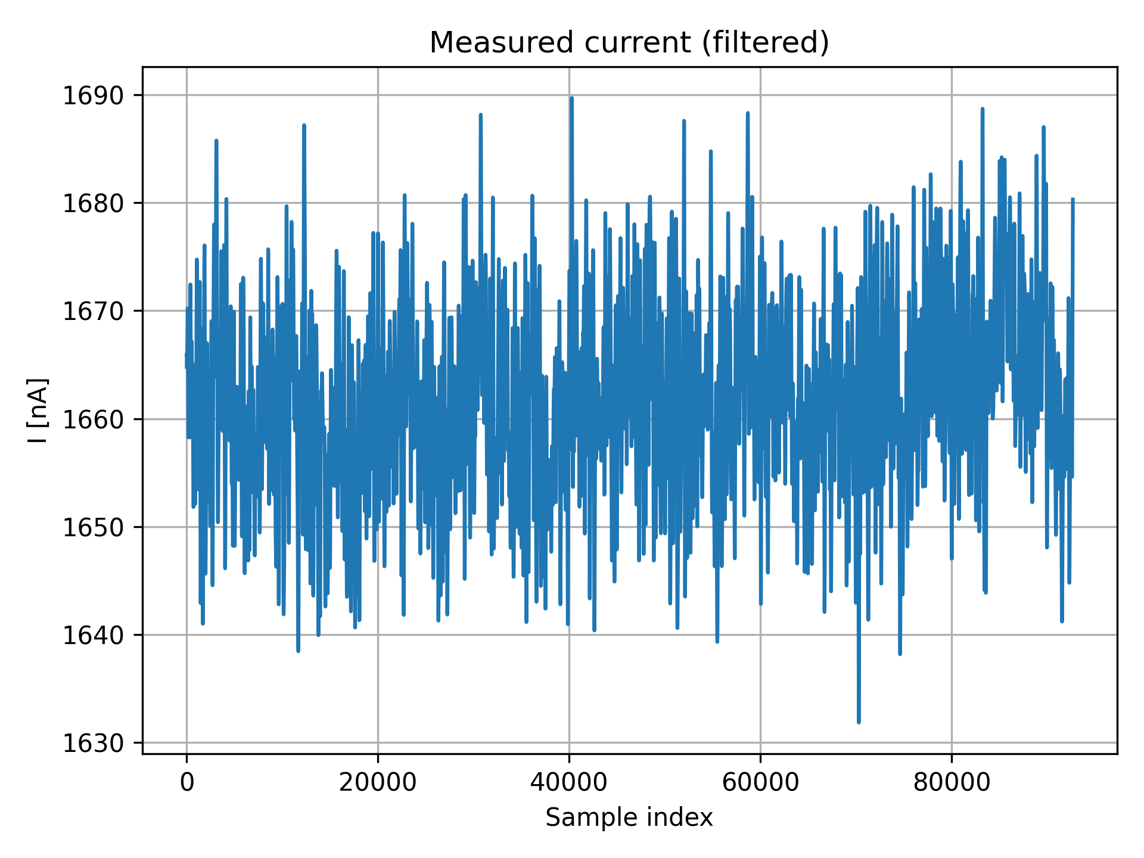
Raport/Images/R0_stlink_current_filtered.png
