Michalek007/CurrentSensingCircuit/Raport/Images/R0_stlink_raw.png

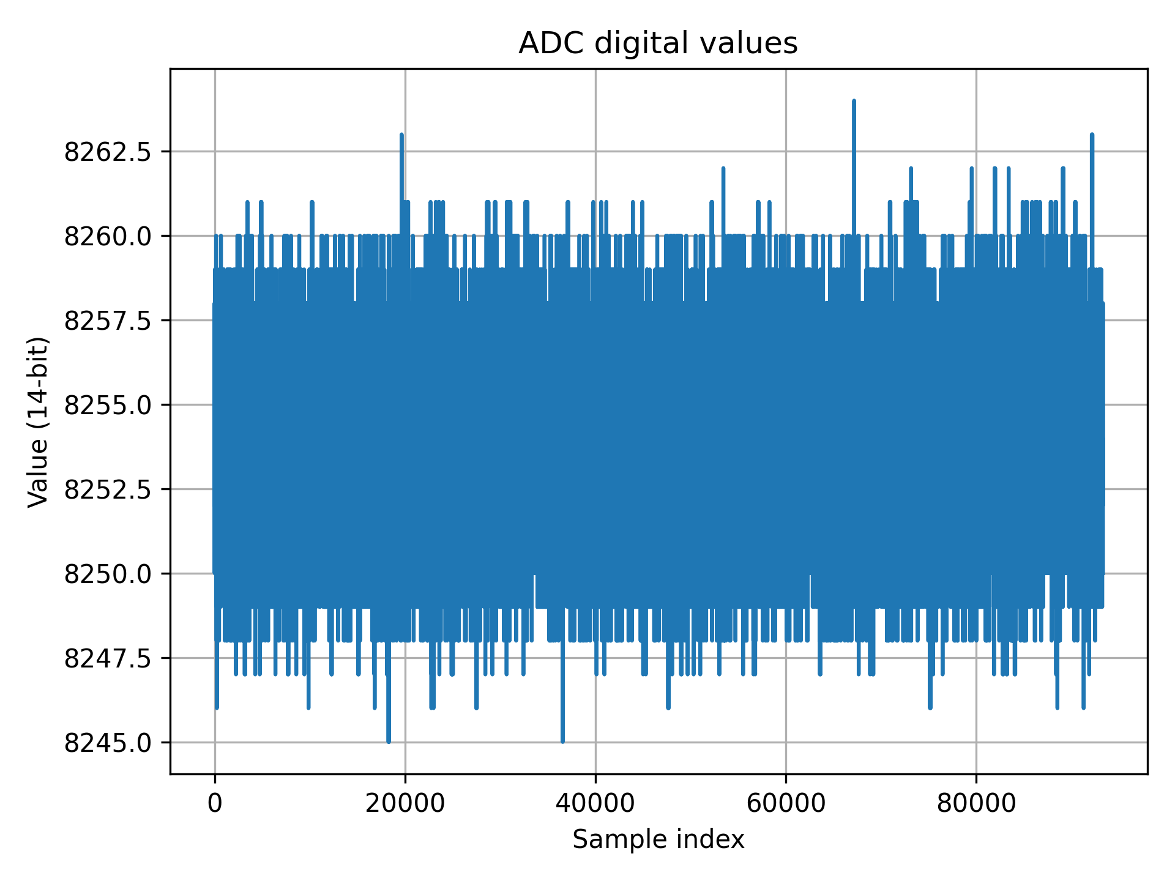
Raport/Images/R0_stlink_raw.png
