Michalek007/CurrentSensingCircuit/Raport/Images/R0_stlink_raw_filtered.png

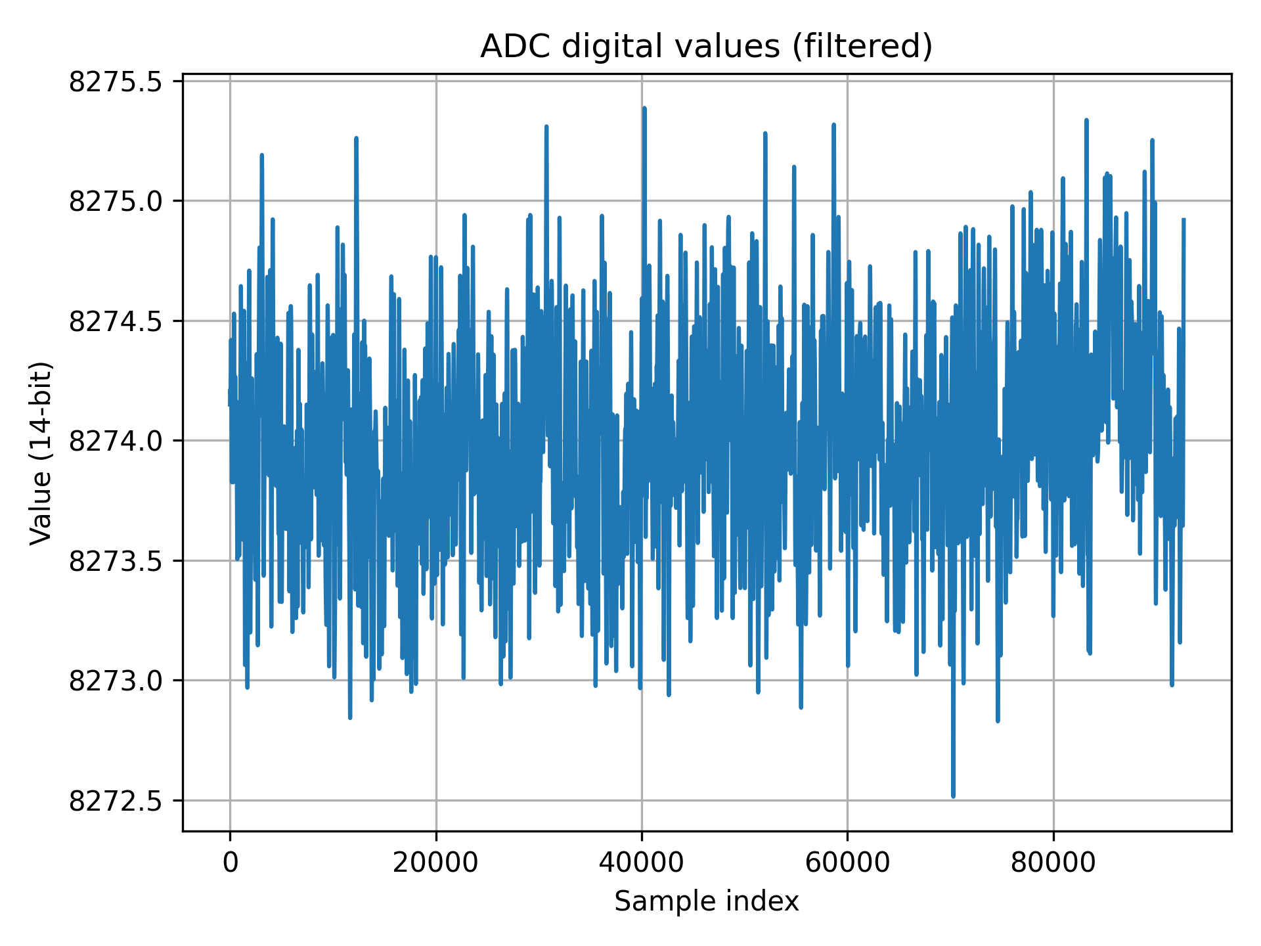
Raport/Images/R0_stlink_raw_filtered.png
