Michalek007/CurrentSensingCircuit/Raport/Images/R0_z_current_filtered.png

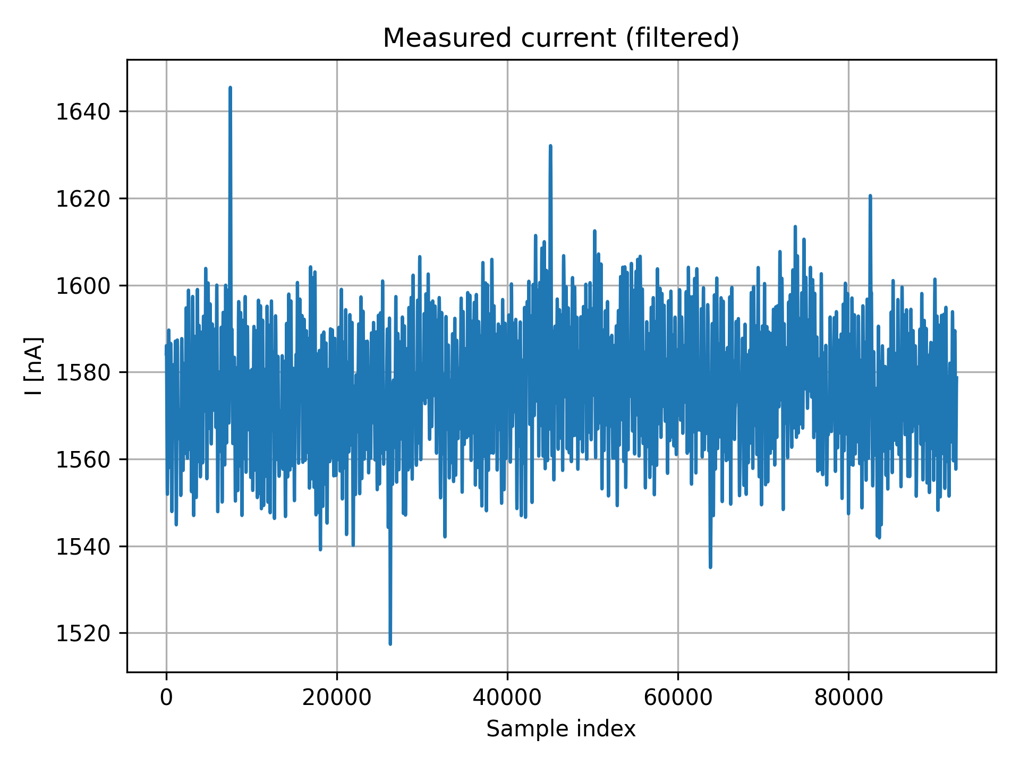
Raport/Images/R0_z_current_filtered.png
