Michalek007/CurrentSensingCircuit/Raport/Images/R0_z_raw_filtered.png

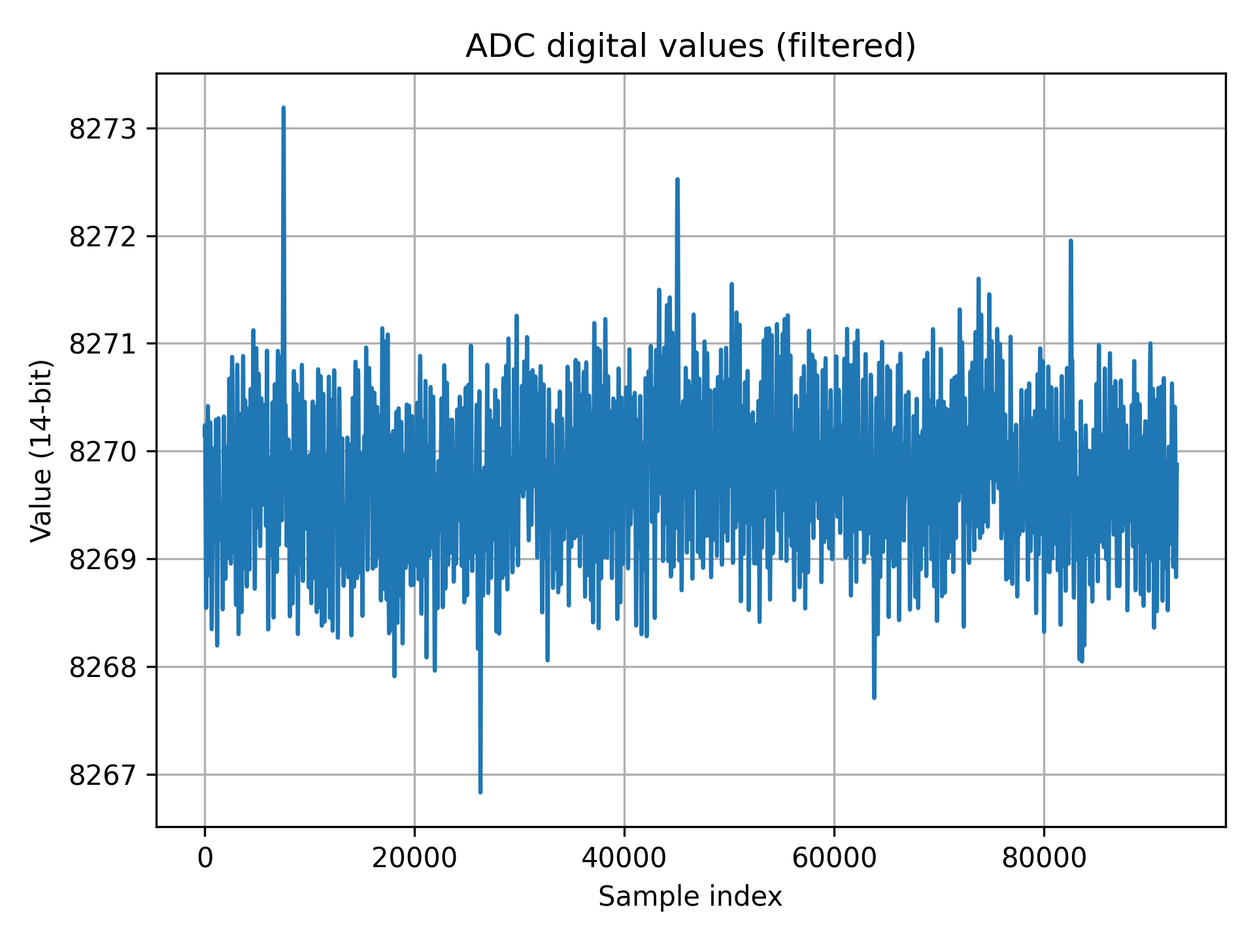
Raport/Images/R0_z_raw_filtered.png
