Michalek007/CurrentSensingCircuit/Raport/Images/R0_z_vadc.png

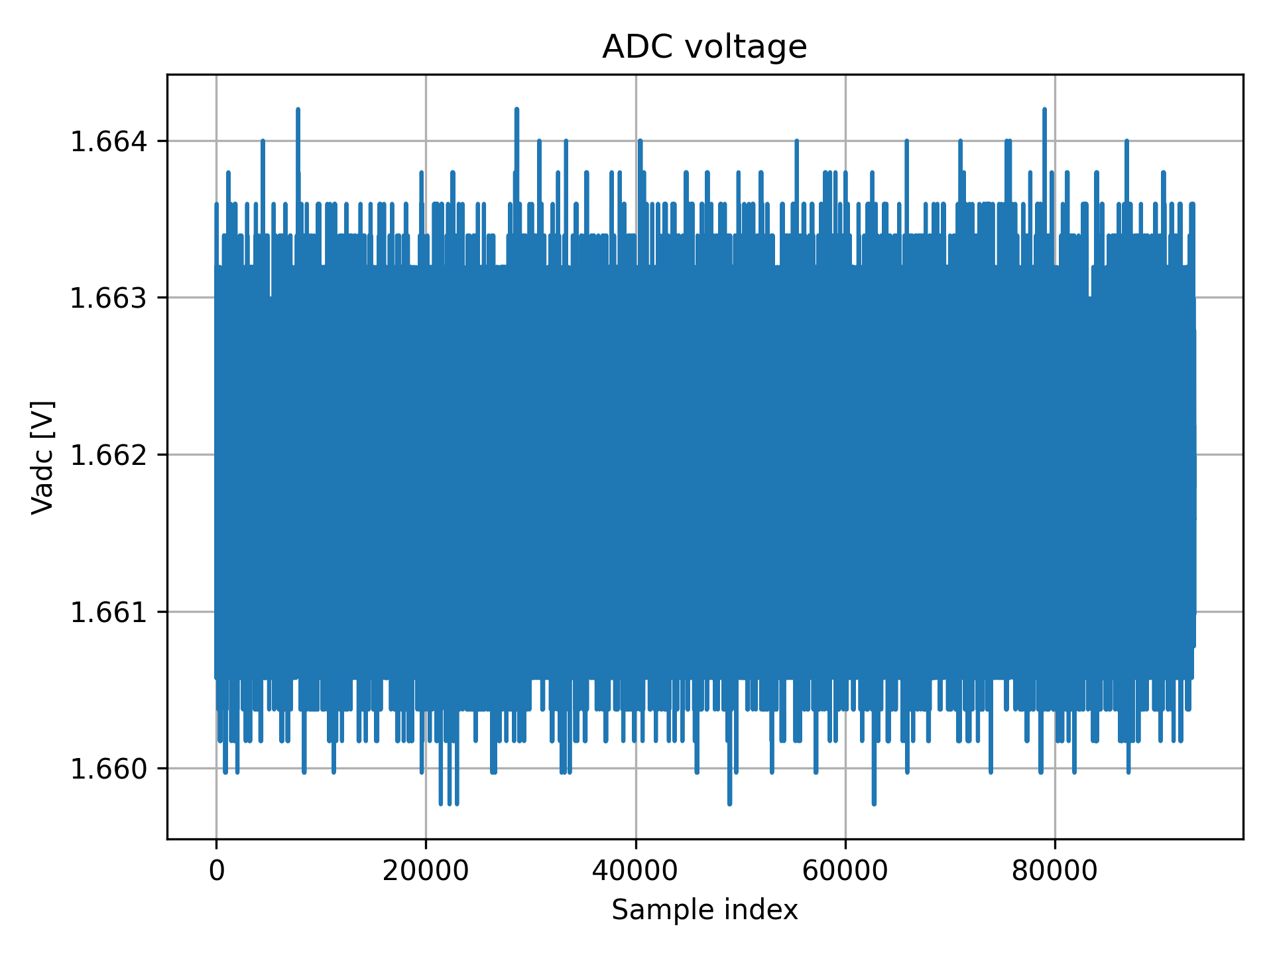
Raport/Images/R0_z_vadc.png
