Michalek007/CurrentSensingCircuit/Raport/Images/R0_z_vadc_filtered.png

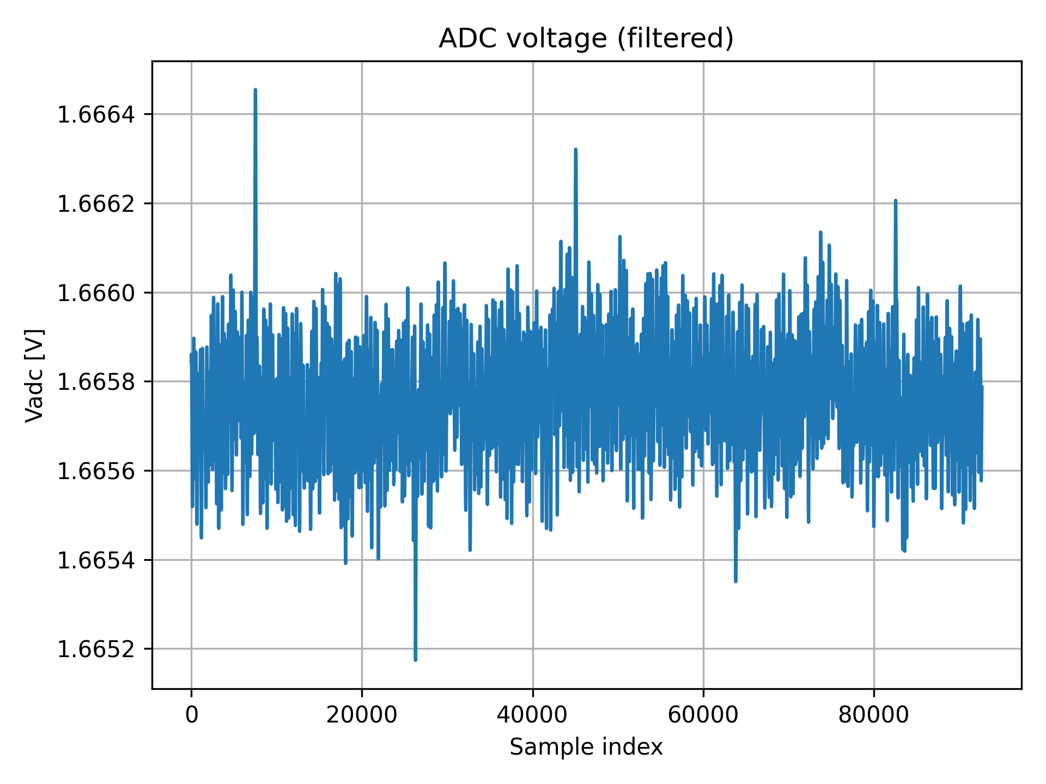
Raport/Images/R0_z_vadc_filtered.png
