Michalek007/CurrentSensingCircuit/Raport/Images/R44k_reverse_raw.png

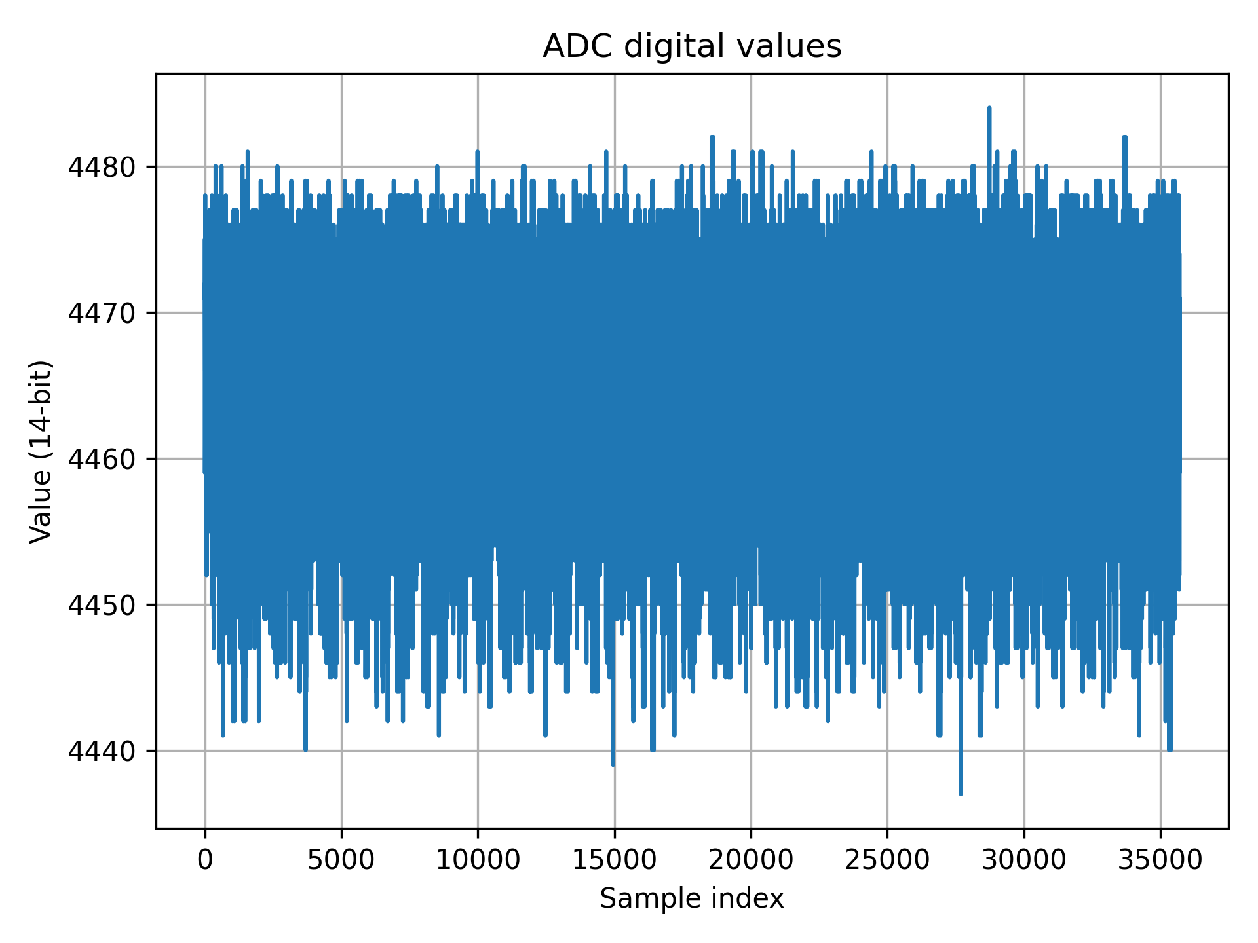
Raport/Images/R44k_reverse_raw.png
