Michalek007/CurrentSensingCircuit/Raport/Images/R44k_reverse_raw_filtered.png

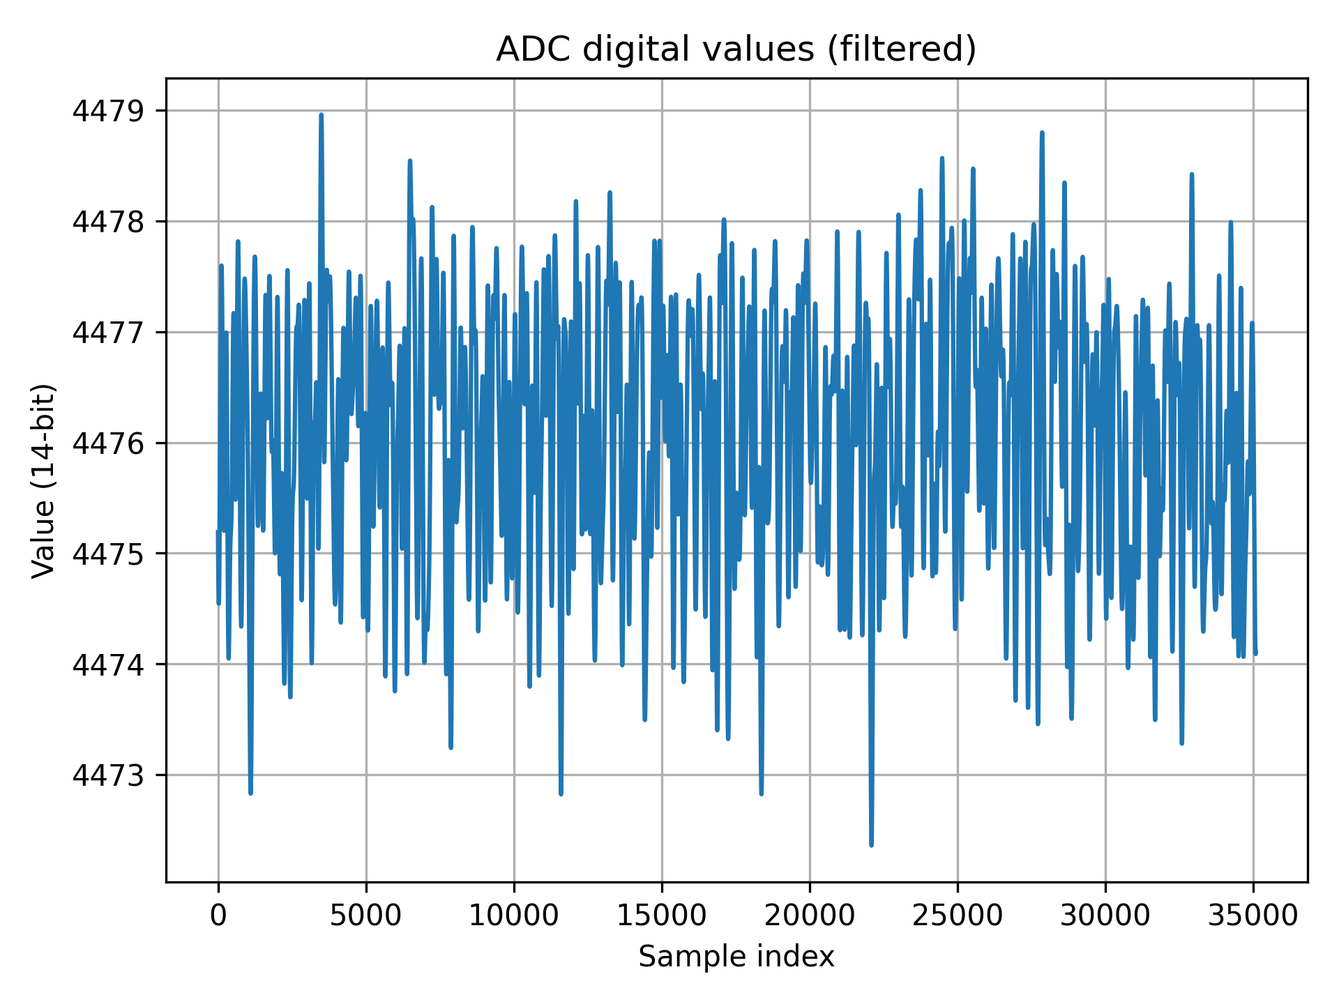
Raport/Images/R44k_reverse_raw_filtered.png
