Michalek007/CurrentSensingCircuit/Raport/Images/R44k_reverse_vadc.png

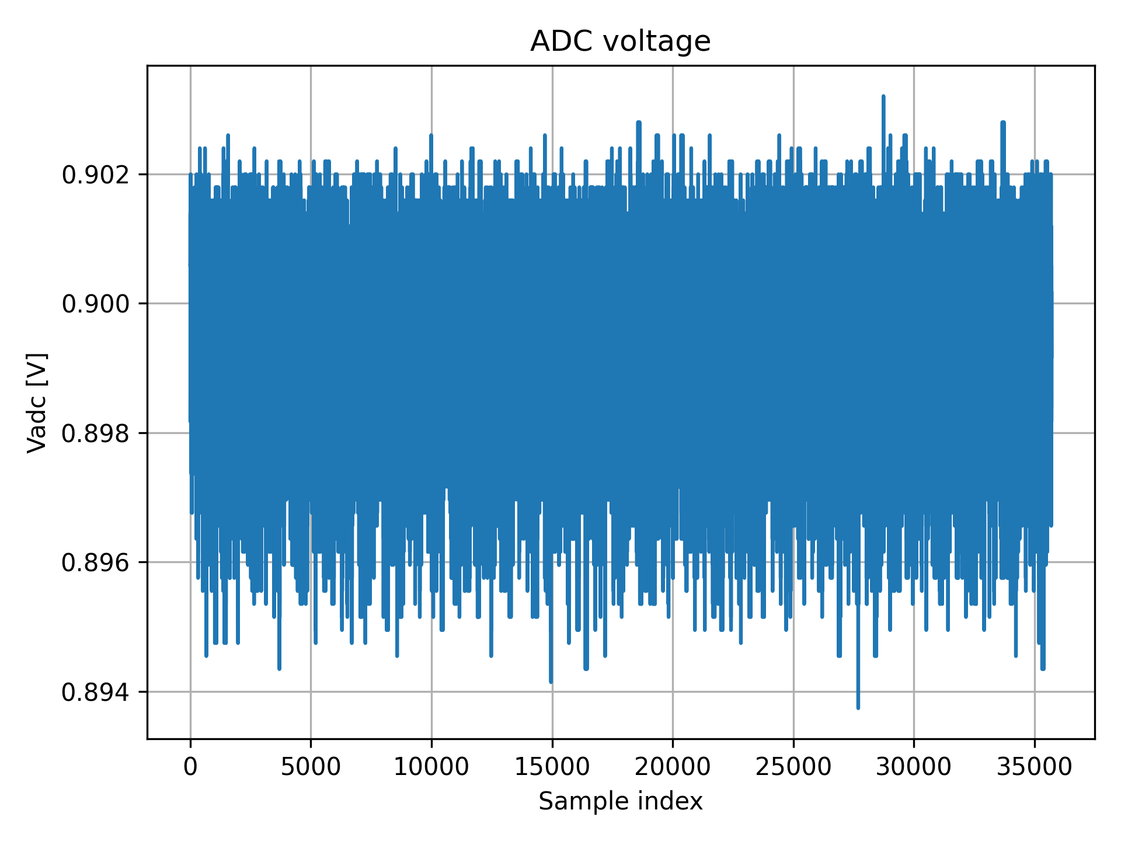
Raport/Images/R44k_reverse_vadc.png
