Michalek007/CurrentSensingCircuit/Raport/Images/R44k_z_raw.png

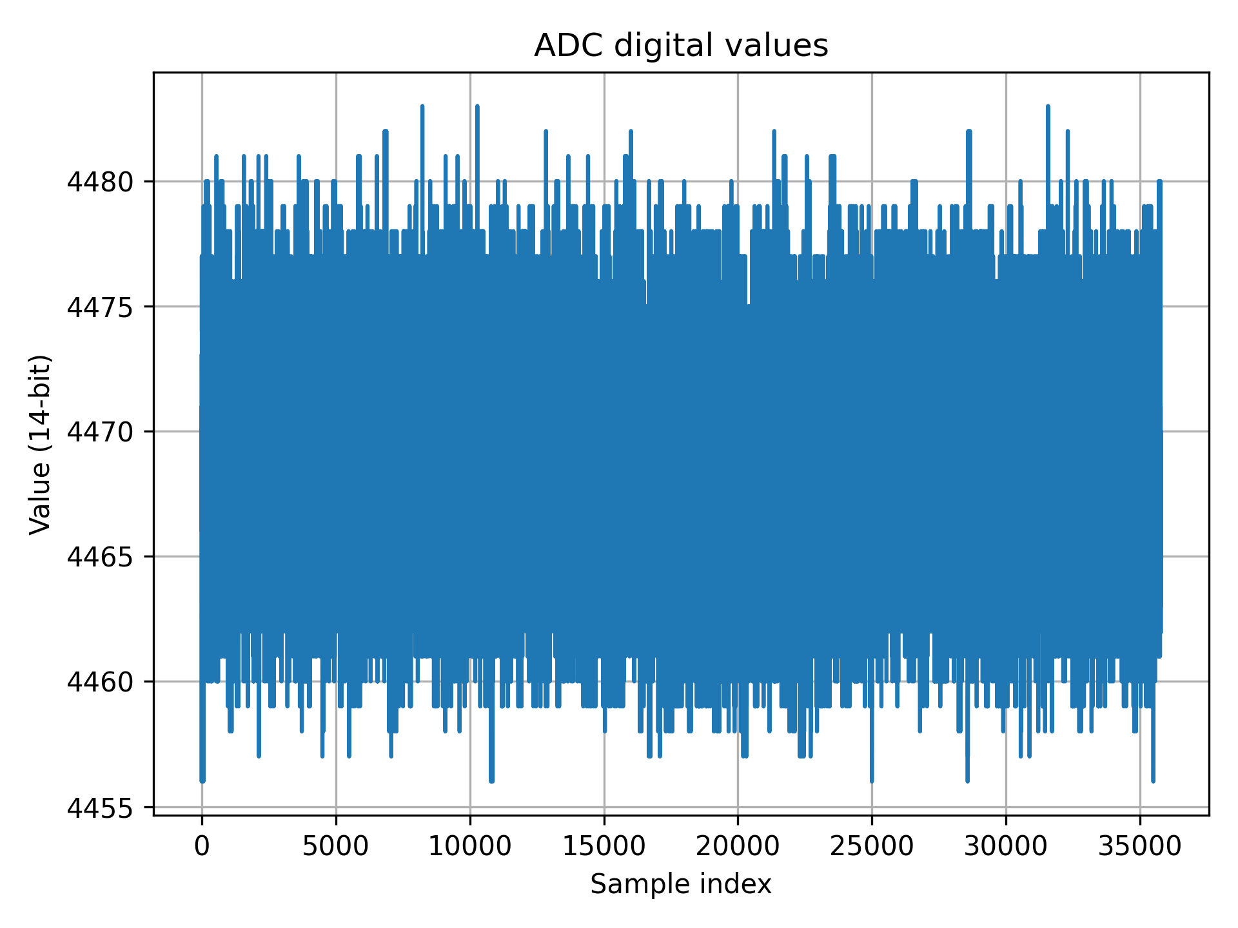
Raport/Images/R44k_z_raw.png
