Michalek007/CurrentSensingCircuit/Raport/Images/R200k_current_filtered.png

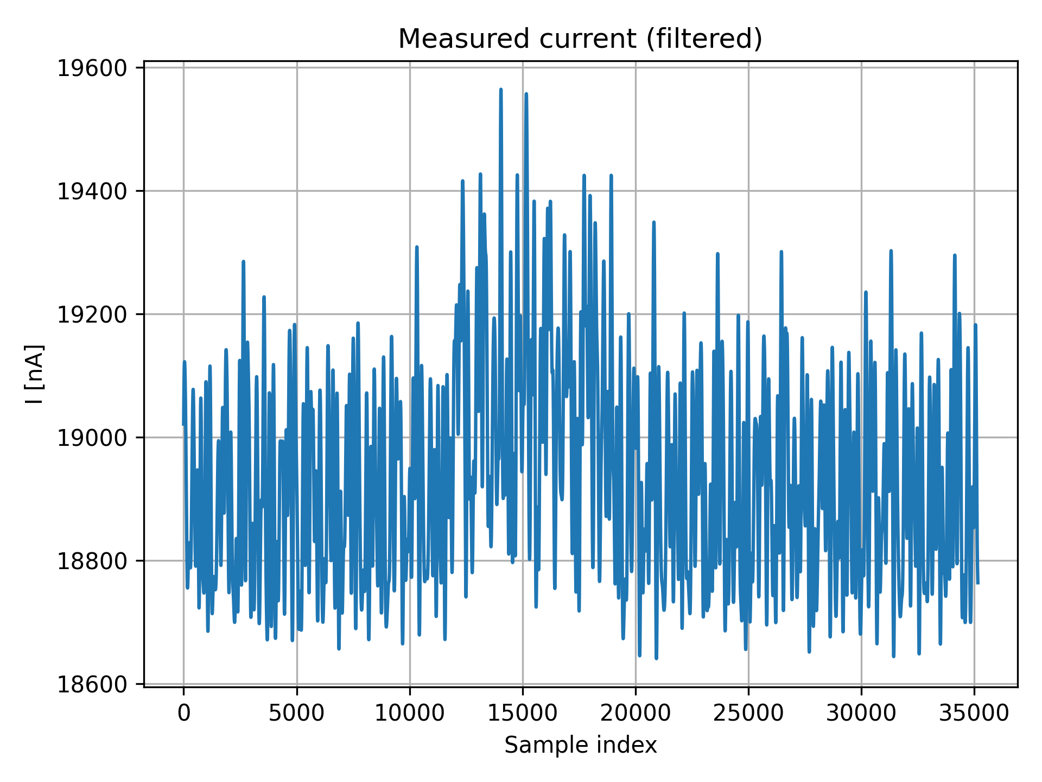
Raport/Images/R200k_current_filtered.png
