Michalek007/CurrentSensingCircuit/Raport/Images/R200k_raw.png

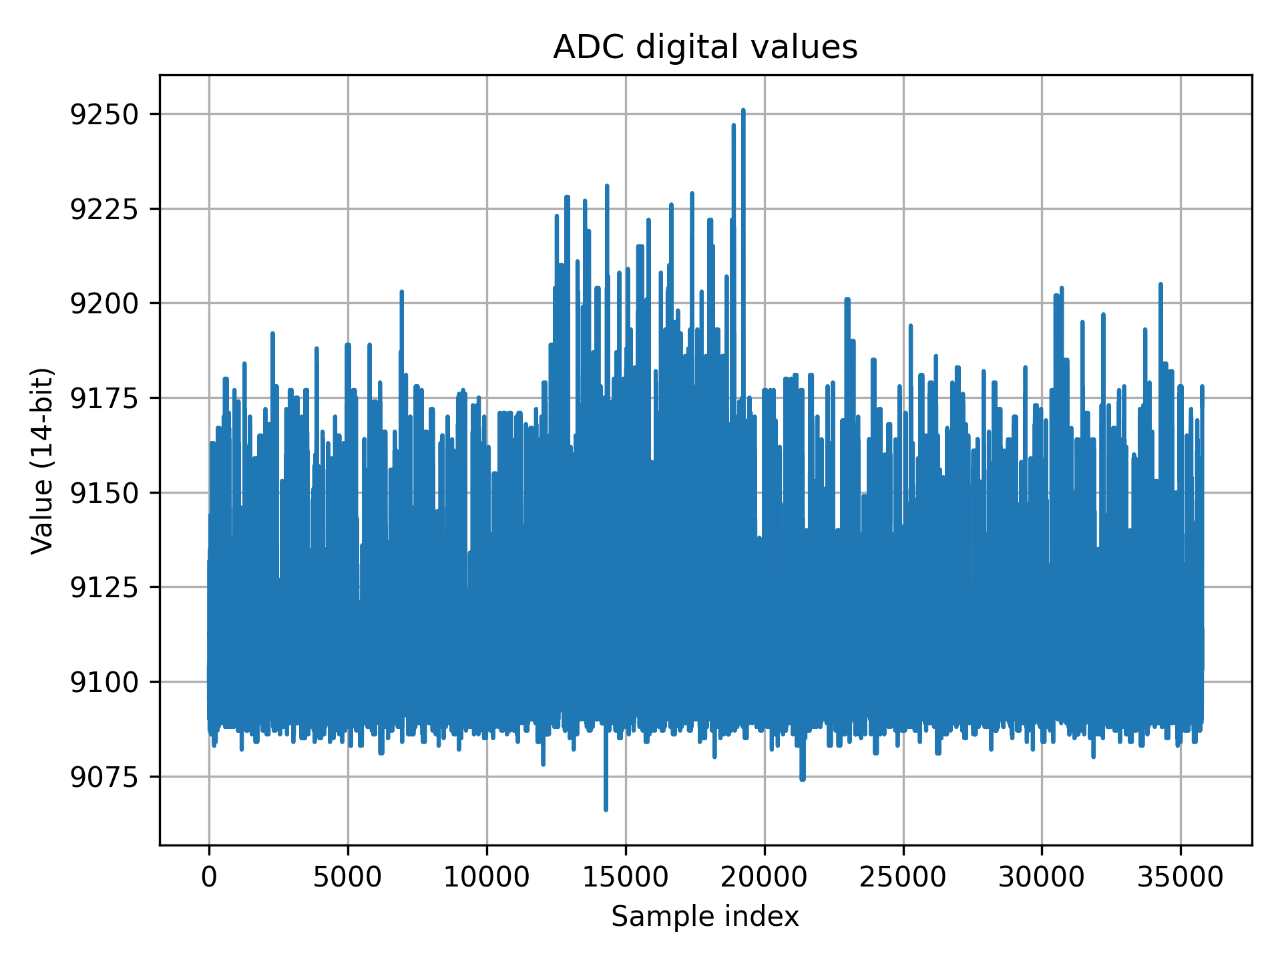
Raport/Images/R200k_raw.png
