Michalek007/CurrentSensingCircuit/Raport/Images/R200k_raw_filtered.png

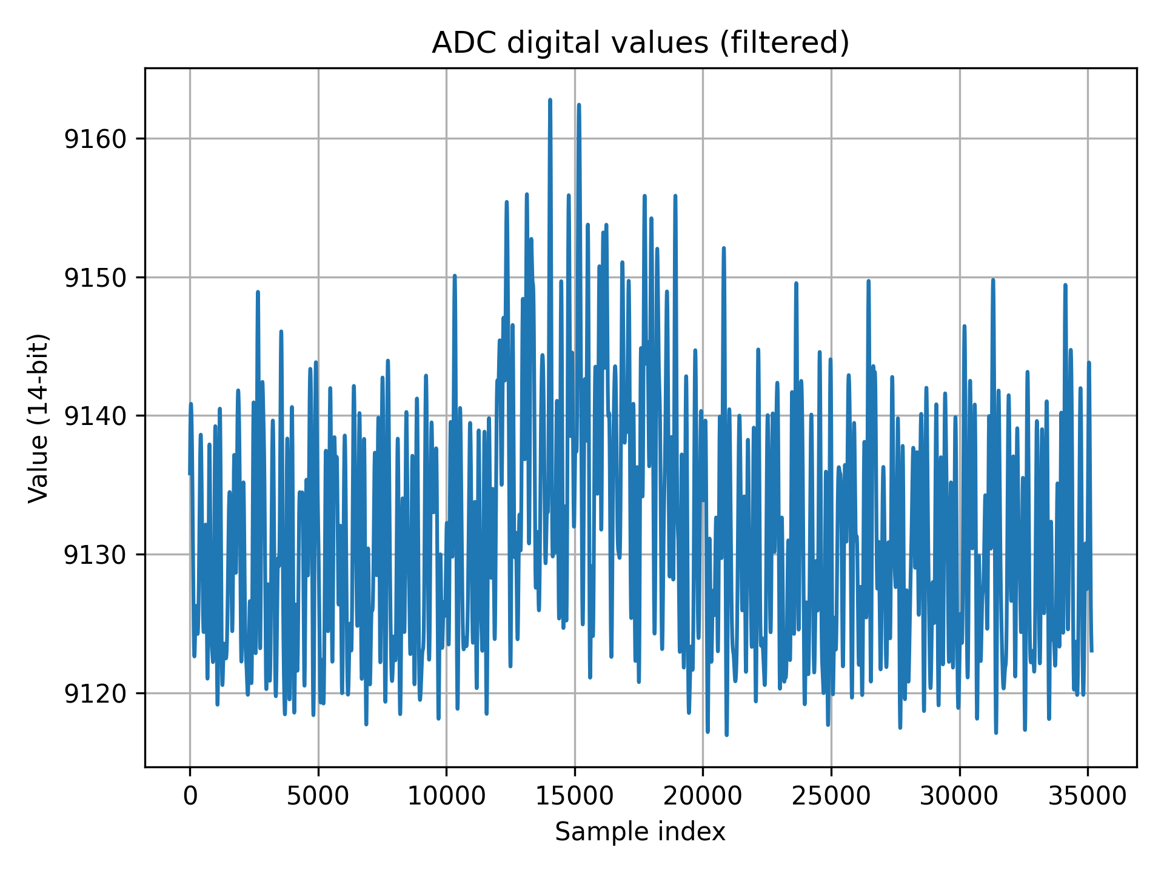
Raport/Images/R200k_raw_filtered.png
