Michalek007/CurrentSensingCircuit/Raport/Images/R940k_current.png

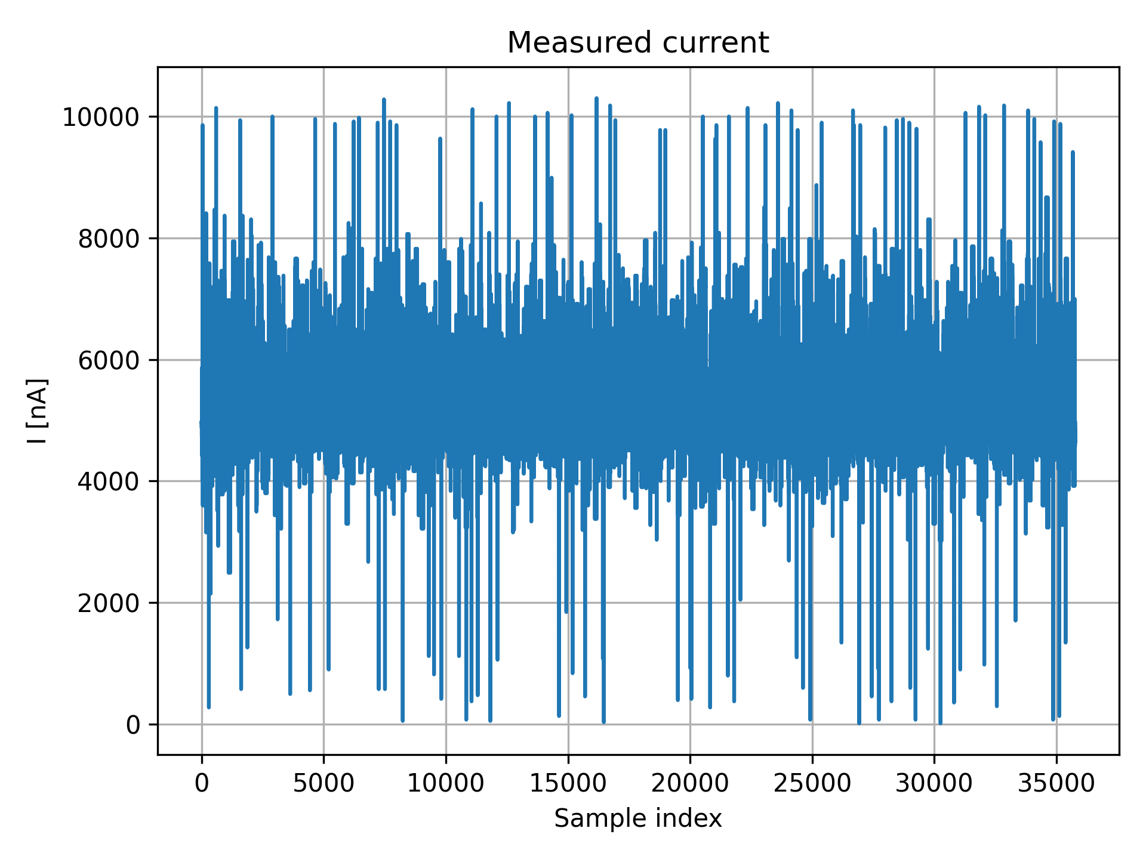
Raport/Images/R940k_current.png
