Michalek007/CurrentSensingCircuit/Raport/Images/R940k_current_filtered.png

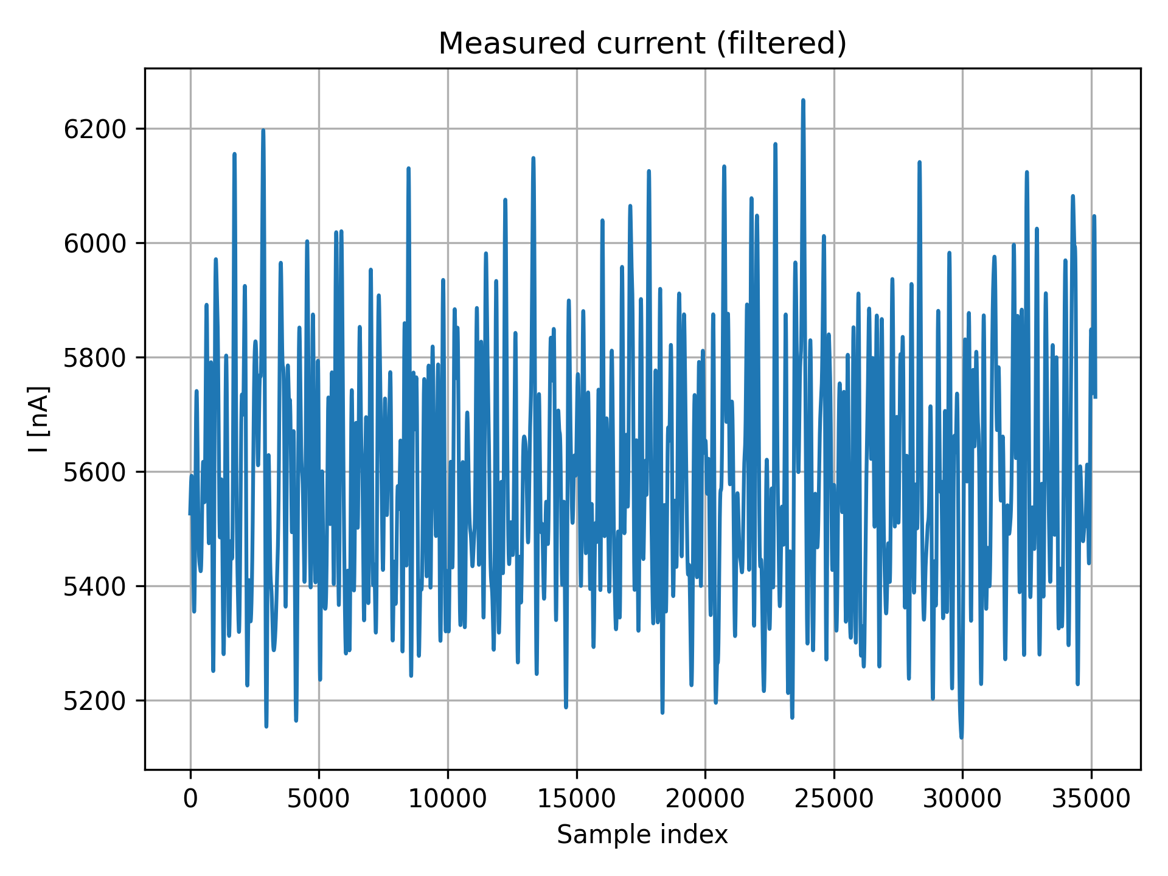
Raport/Images/R940k_current_filtered.png
