Michalek007/CurrentSensingCircuit/Raport/Images/R940k_hist.png

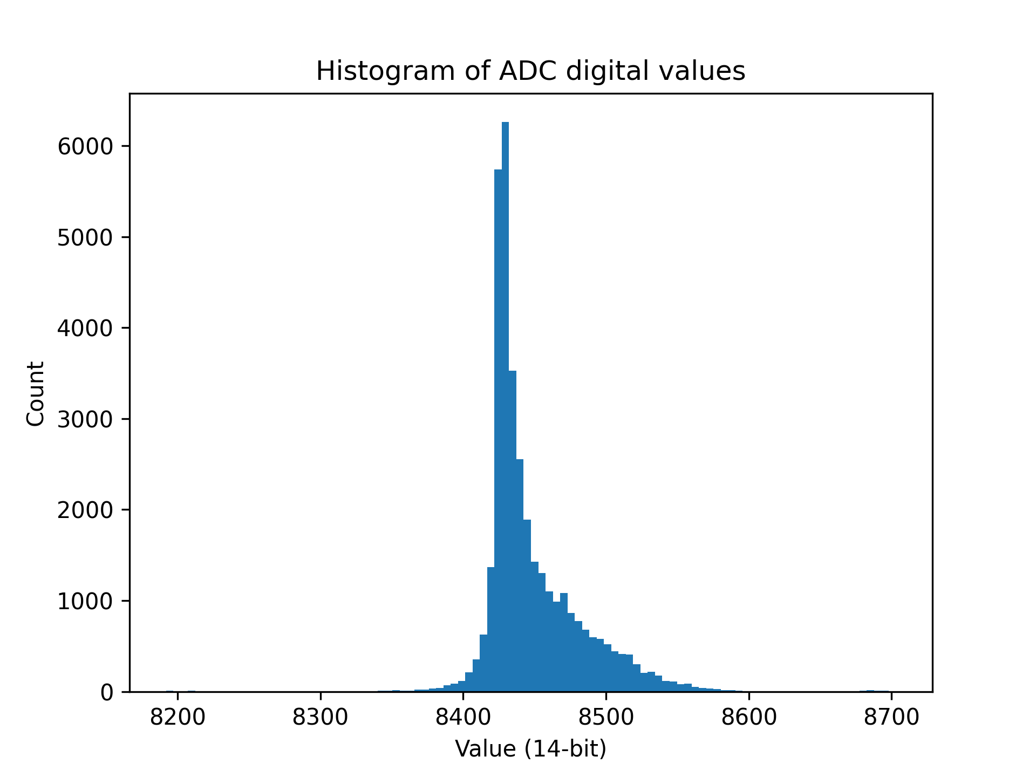
Raport/Images/R940k_hist.png
