Michalek007/CurrentSensingCircuit/Raport/Images/R940k_raw.png

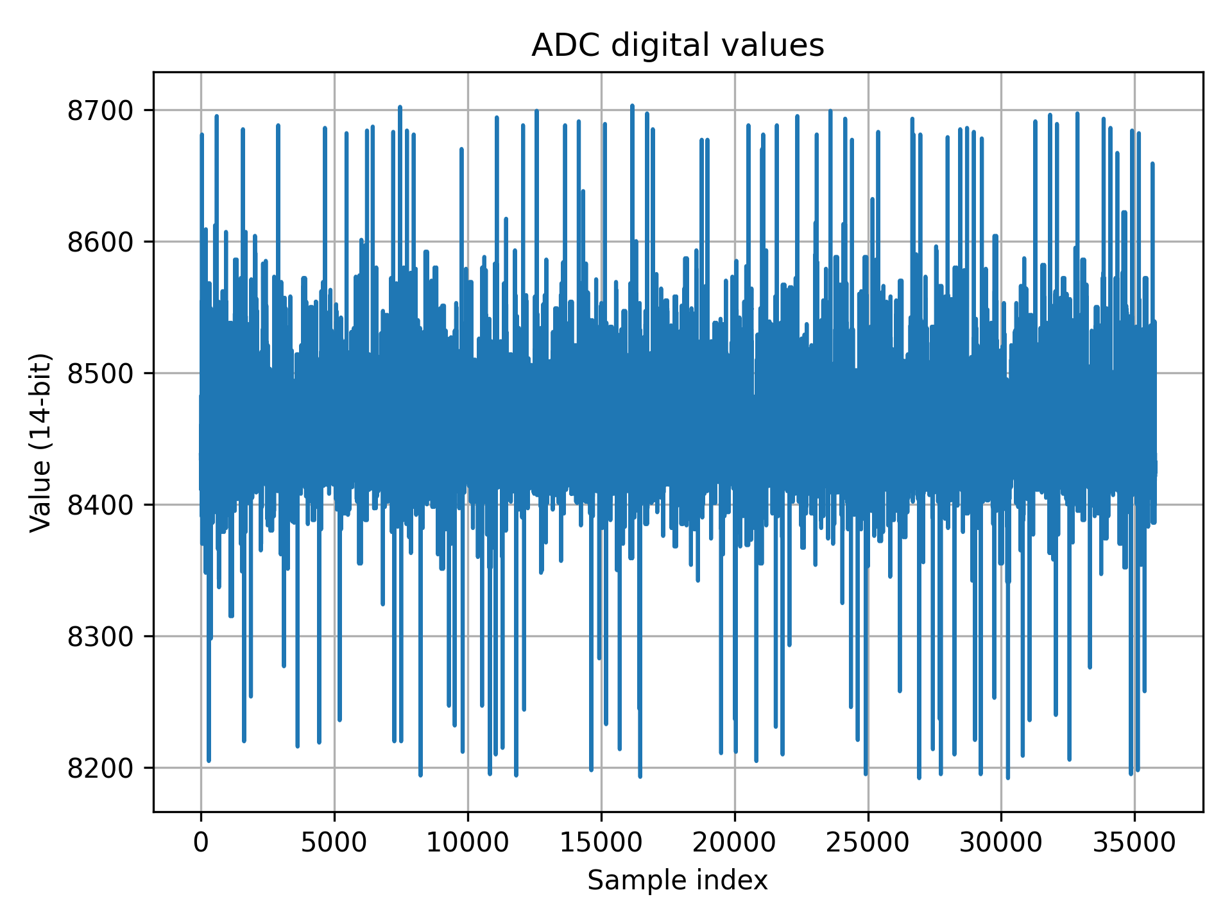
Raport/Images/R940k_raw.png
