Michalek007/CurrentSensingCircuit/Raport/Images/R940k_vadc_filtered.png

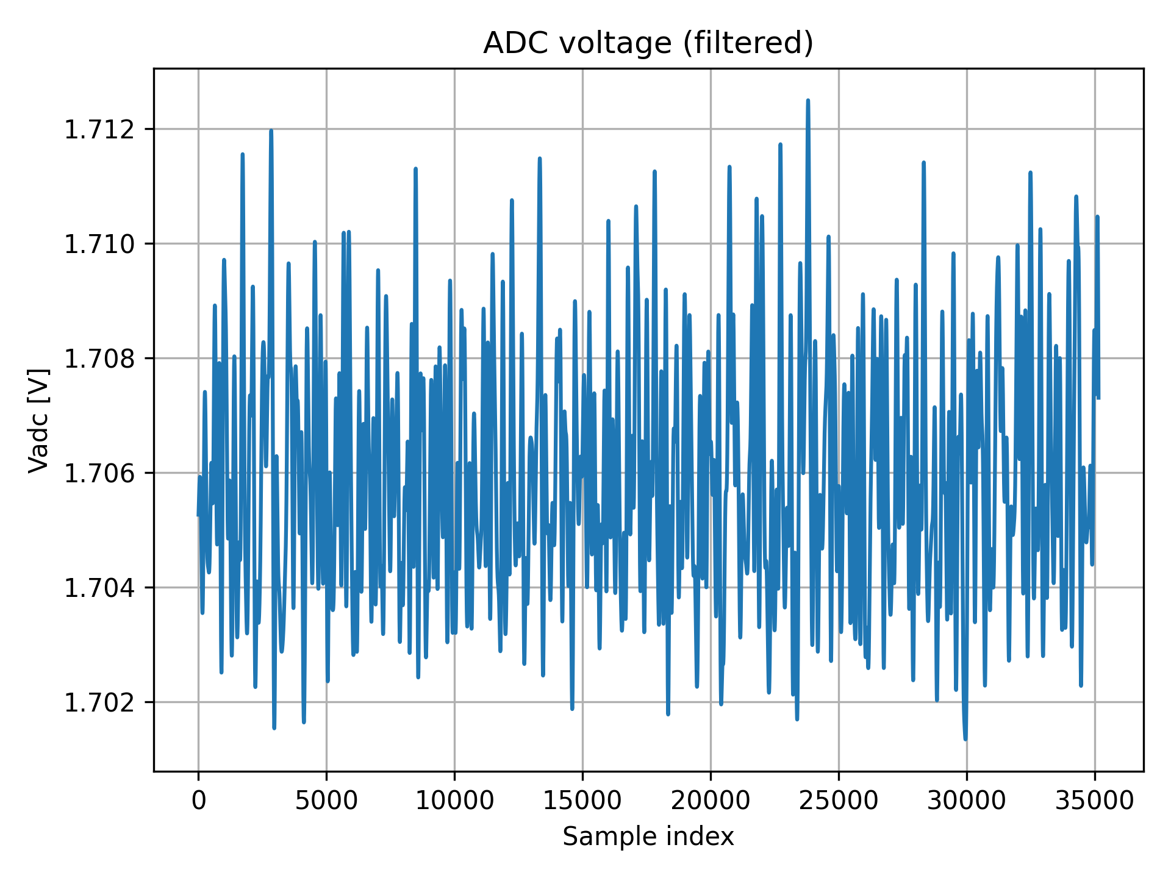
Raport/Images/R940k_vadc_filtered.png
