Michalek007/CurrentSensingCircuit/Symulacje/test.asc

R1: res; 8Meg
R2: res; 2Meg
R3: res; 100k
R4: res; 11k
R5: res; 8Meg
U1: UniversalOpAmp3
V1: voltage; 3.3
V2: voltage; 1.65
V3: voltage; 1.65
Named nets: Vref, Vcm, 0, Vcc
.dc V3 0 3.3 0.3
.meas Icm AVG I(R1)+I(R5)
