Michalek007/CurrentSensingCircuit/Symulacje/ferrite.asc

C1: cap; {C1}
C2: cap; 0.5µ; Rser=0.1
R1: res; 10
R2: res; 10k
U1: BLM21BB050SN1
V1: voltage; ""; AC 1
Named nets: 0, Vout, Vin
.ac dec 30 1 100meg
.param C1 10u
.step dec param C1 1u 100u 10
