Michalek007/CurrentSensingCircuit/Symulacje/LPF.asc

C1: cap; 2.2n
R1: res; 50
R2: res; 510
R3: res; 11k
R4: res; 100k
U1: tlv6001
V1: voltage; 1.65
V2: voltage; ""; AC 1
V3: voltage; 1.65
Named nets: VDD, Vout, 0, Vref
.ac dec 1000 1 10meg
