Michalek007/CurrentSensingCircuit/Symulacje/INA333.asc

B1: bv; V=0;0.8m*(rand(1e8*time)-0.5)
C1: cap; 1µ
C3: cap; 100n
I1: current; {Imeas}
I2: current; {Imeas}
R1: res; {Rg}
R2: res; 100k
R3: res; {Rin+1m}
R4: res; 10k
R5: res; 10k
R6: res; {Rmeas}
R7: res; 1k
R8: res; 10Meg
R9: res; {10meg-Rin+1m}
R10: res; 1k
R11: res; 100k
R12: res; 100k
U1: INA333
U2: UniversalOpAmp3
U3: UniversalOpAmp3
U4: UniversalOpAmp3
V1: voltage; 3.3; Rser=2
V2: voltage; 0
V3: voltage; 0; AC 0
V4: voltage; 0; AC 0
Named nets: Vcc, Vee, 0, Vref, Vout, Vref2, Vcm
;.step param Vd 0 1 0.05
;.param Vd 0.1
;.dc V3 -0.1 0.1 0.02
.ac dec 20 10 1meg
;.dc V3 0 3.3 0.33
.param Rg 10
.param Rmeas 100
.param Imeas 1u
;.step param Imeas -0.1u 0.1u 0.01u
;.op
;.step param Imeas -1u 1u 0.1u
;.tran 10m
.param Rin 1meg
;.step param Rin 0 10meg 1meg
