Michalek007/CurrentSensingCircuit/Symulacje/Noise_gen.asc

C1: cap; 10n
C2: cap; 330n
I1: current; 1n
I2: current; 1n
R1: res; 10k
R2: res; 100k
R3: res; 10k
R4: res; 10k
R5: res; 10
R6: res; 110k
R7: res; 10k
R8: res; 100
R9: res; 1k
R10: res; 10Meg
R11: res; 1m
R12: res; 50
R13: res; 10k
U1: tsv991
U2: tsv991
U3: ina333
U4: UniversalOpAmp3
V1: voltage; 3.3
V2: voltage; 0
V3: voltage; 0; AC 1
V6: voltage; SINE(0 1 1k)
Named nets: VDD, VSS, 0, Vin, Vout, Vref, Vn, Vrefn, Vnint
;.ac dec 10 10meg 30
;.tran 100m
.noise V(Vrefn) V3 dec 30 1 1meg
fg=~318k
220n lub 330n jest ok
