Michalek007/CurrentSensingCircuit/Symulacje/Zener.asc

B1: bv; V=(100u*white(100e6*time))
C1: cap; 100n
D1: zener; Vref2V5
E1: e; 1
R1: res; 820
R2: res; 100k
R3: res; 1k
R4: res; 9k
V1: voltage; 3.3; Rser=1
Named nets: 0, Vout, Vfil, Vp, Vn
.tran 10u
.model Vref2V5 D(BV=2.49 IBV=400u)
