Michalek007/CurrentSensingCircuit/Symulacje/psu.asc

C1: cap; 10µ
C2: cap; 100µ; Rser=0.5
R1: res; 33
U1: LT1117-3.3
V1: voltage; PULSE(0 5 0.5m 100u 100u 5m)
Named nets: 0, IN, OUT
.tran 3m
