Michalek007/CurrentSensingCircuit/Symulacje/sumator.asc

R1: res; 10k
R2: res; 4Meg
R3: res; 1k
R4: res; 1k
R5: res; 10k
U1: UniversalOpAmp3
V1: voltage; 3.3
V2: voltage; 0.8
V3: voltage; 0.8
Named nets: 0, VDD, VOUT
.dc V2 -3.5 3.5 0.1
