Michalek007/CurrentSensingCircuit/KiCad/AUPWSW.kicad_pcb

## KiCad design KiCad/AUPWSW.kicad_pcb (2025-12-08)

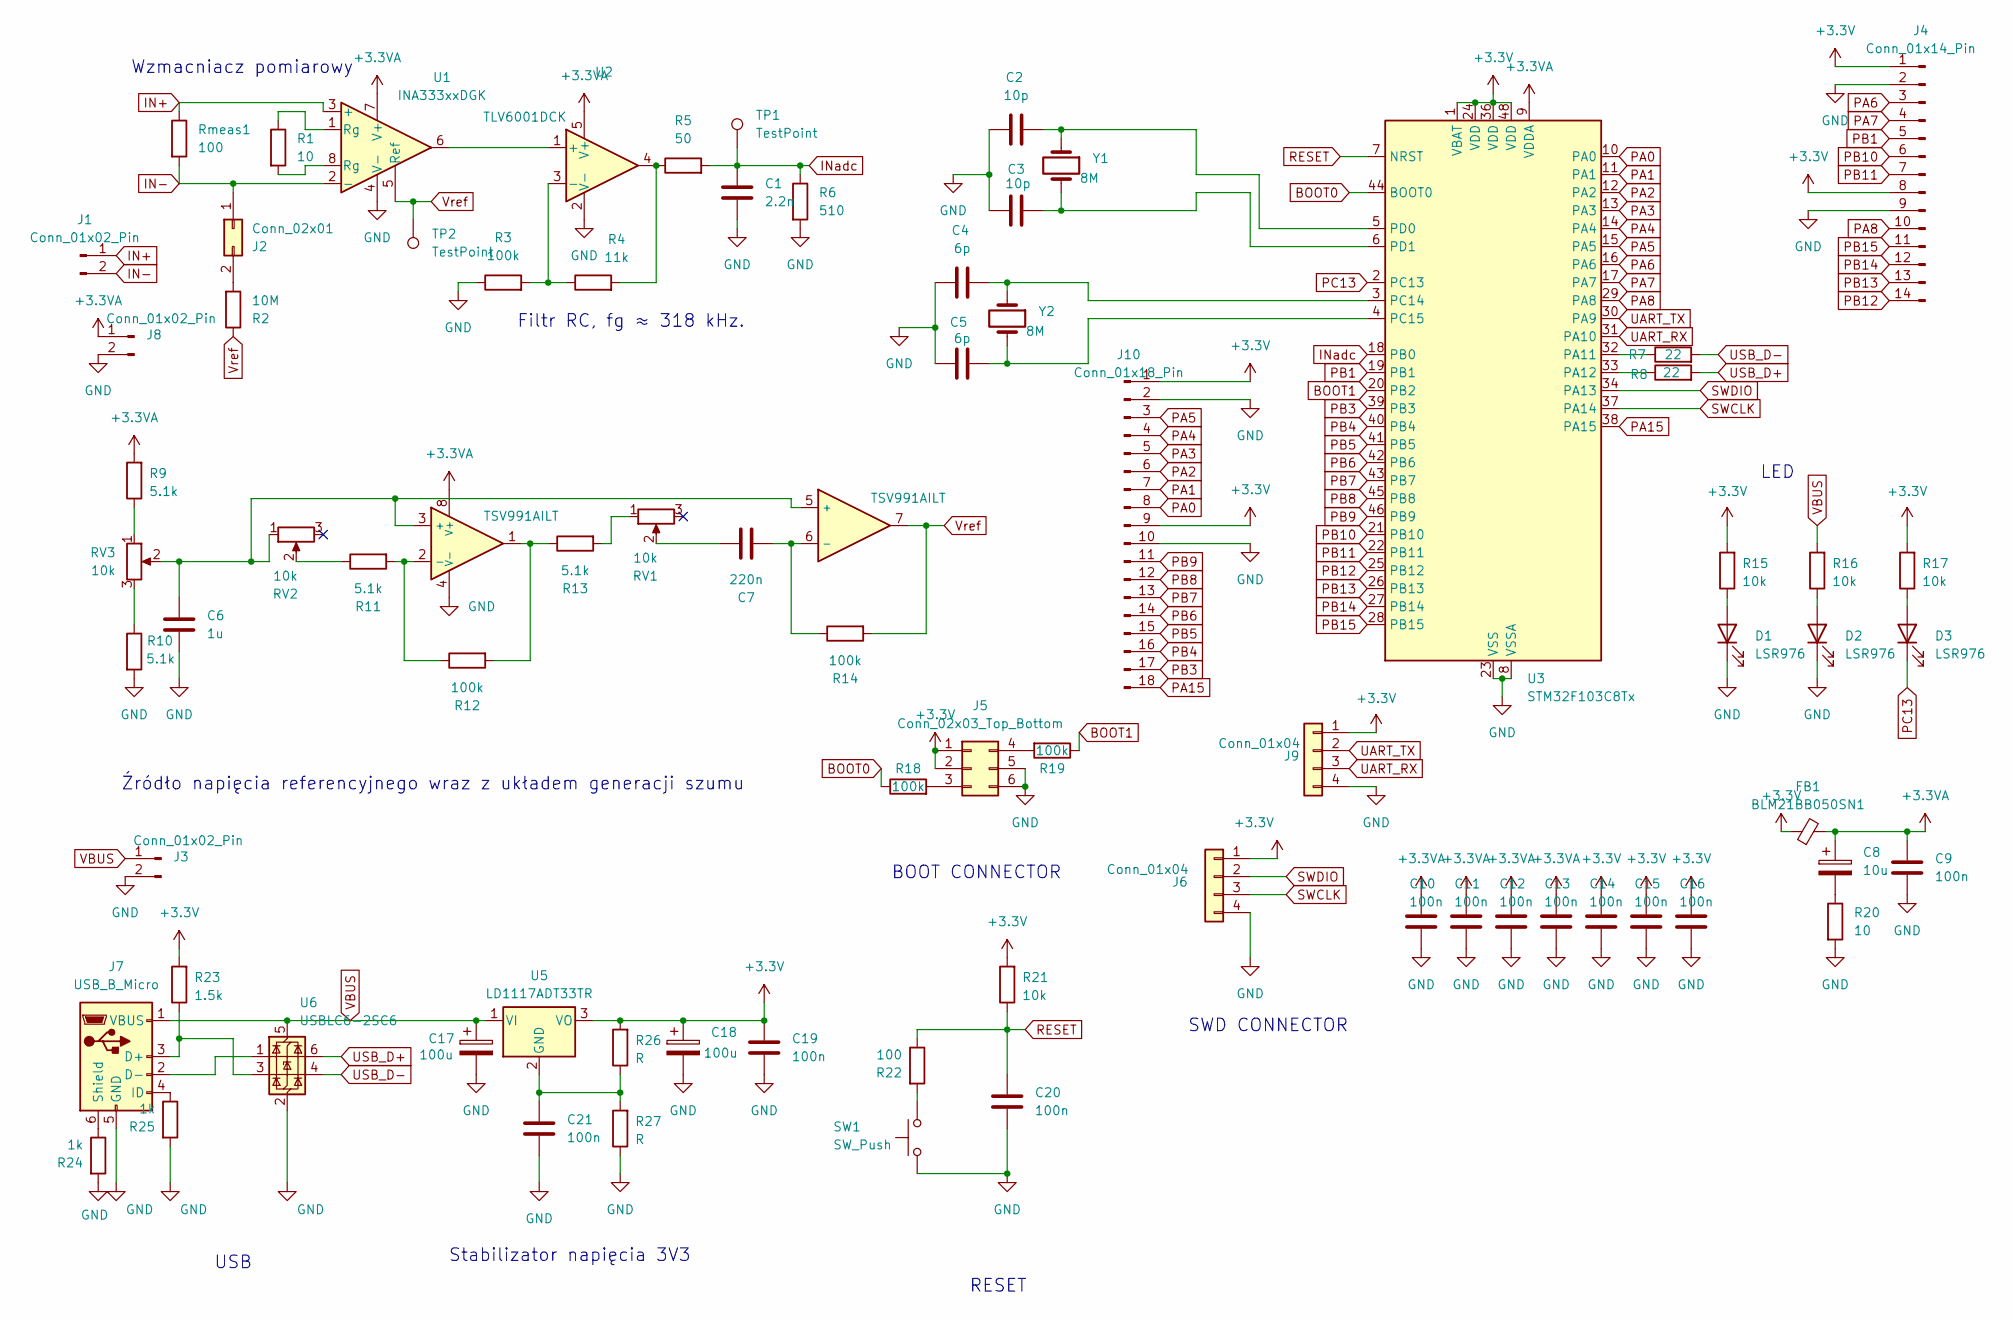
[picture p70: schematic AUPWSW.kicad_sch, Układ do pomiaru natężenia prądu poniżej 1LSB przetwornika …]

Parts:
C1: 2.2n; C_0805_2012Metric_Pad1.18x1.45mm_HandSolder
C2, C3: 10p; C_0603_1608Metric_Pad1.08x0.95mm_HandSolder
C4, C5: 6p; C_0603_1608Metric_Pad1.08x0.95mm_HandSolder
C6: 1u; C_0805_2012Metric_Pad1.18x1.45mm_HandSolder
C7: 220n; C_0805_2012Metric_Pad1.18x1.45mm_HandSolder
C8: 10u; CP_Elec_5x3
C9, C10, C11, C12, C13, C14, C15, C16, C19, C20, C21: 100n; C_0805_2012Metric_Pad1.18x1.45mm_HandSolder
C17, C18: 100u; CP_Elec_6.3x3
D1, D2, D3: LSR976; LED_0805_2012Metric_Pad1.15x1.40mm_HandSolder
FB1: BLM21BB050SN1; R_0805_2012Metric_Pad1.20x1.40mm_HandSolder
J1, J3, J8: Conn_01x02_Pin; PinHeader_1x02_P2.54mm_Vertical
J2: Conn_02x01; PinHeader_1x02_P2.54mm_Vertical
J4: Conn_01x14_Pin; PinHeader_1x14_P2.54mm_Vertical
J5: Conn_02x03_Top_Bottom; PinHeader_2x03_P2.54mm_Vertical
J6, J9: Conn_01x04; PinHeader_1x04_P2.54mm_Vertical
J7: USB_B_Micro; USB3080-30-00-A
J10: Conn_01x18_Pin; PinHeader_1x18_P2.54mm_Vertical
R1, R20: 10; R_0805_2012Metric_Pad1.20x1.40mm_HandSolder
R2: 10M; R_0805_2012Metric_Pad1.20x1.40mm_HandSolder
R3, R12, R14, R18, R19: 100k; R_0805_2012Metric_Pad1.20x1.40mm_HandSolder
R4: 11k; R_0805_2012Metric_Pad1.20x1.40mm_HandSolder
R5: 50; R_0805_2012Metric_Pad1.20x1.40mm_HandSolder
R6: 510; R_0805_2012Metric_Pad1.20x1.40mm_HandSolder
R7, R8: 22; R_0805_2012Metric_Pad1.20x1.40mm_HandSolder
R9, R10, R11, R13: 5.1k; R_0805_2012Metric_Pad1.20x1.40mm_HandSolder
R15, R16, R17, R21: 10k; R_0805_2012Metric_Pad1.20x1.40mm_HandSolder
R22: 100; R_0805_2012Metric_Pad1.20x1.40mm_HandSolder
R23: 1.5k; R_0805_2012Metric_Pad1.20x1.40mm_HandSolder
R24, R25: 1k; R_0805_2012Metric_Pad1.20x1.40mm_HandSolder
R26, R27: R; R_0805_2012Metric_Pad1.20x1.40mm_HandSolder
RV1, RV2, RV3: 10k; 1806WSMD
Rmeas1: 100; R_0805_2012Metric_Pad1.20x1.40mm_HandSolder
SW1: SW_Push; TL3305BF160QG
TP1, TP2: TestPoint; TestPoint_THTPad_1.5x1.5mm_Drill0.7mm
U1: INA333xxDGK; VSSOP-8_3x3mm_P0.65mm
U2: TLV6001DCK; SOT-353_SC-70-5
U3: STM32F103C8Tx; LQFP-48_7x7mm_P0.5mm
U4: TSV991AILT; SOIC127P600X175-8N
U5: LD1117ADT33TR; TO228P972X240-3N
U6: USBLC6-2SC6; SOT-23-6
Y1: 8M; HC49SSDLF800MHZ
Y2: 8M; ABS2532768KHZT

Connections:
+3.3V: C14.1, C15.1, C16.1, C18.1, C19.1, FB1.1, J4.1, J4.8, J5.1, J5.2, J6.1, J9.1, J10.1, J10.9, R15.2, R17.2, R21.2, R23.2, R26.2, U3.1 (VBAT), U3.24 (VDD), U3.36 (VDD), U3.48 (VDD), U5.3 (VO)
+3.3VA: C8.1, C9.1, C10.1, C11.1, C12.1, C13.1, FB1.2, J8.1, R9.2, U1.7 (V+), U2.5 (V+), U3.9 (VDDA), U4.8 (V+)
BOOT0: R18.1, U3.44 (BOOT0)
BOOT1: R19.1, U3.20 (PB2)
GND: C1.2, C2.2, C3.2, C4.2, C5.2, C6.2, C9.2, C10.2, C11.2, C12.2, C13.2, C14.2, C15.2, C16.2, C17.2, C18.2, C19.2, C20.2, C21.2, D1.1 (K), D2.1 (K), J3.2, J4.2, J4.9, J5.5, J5.6, J6.4, J7.5 (GND), J8.2, J9.4, J10.2, J10.10, R3.1, R6.2, R10.2, R20.2, R24.2, R25.2, R27.1, SW1.1, U1.4 (V-), U2.2 (V-), U3.8 (VSSA), U3.23 (VSS), U3.35 (VSS), U3.47 (VSS), U4.4 (V-), U6.2 (GND)
IN+: J1.1, Rmeas1.1, U1.3 (+)
IN-: J1.2, J2.1, Rmeas1.2, U1.2 (-)
INadc: C1.1, R5.2, R6.1, TP1.1, U3.18 (PB0)
unnamed: C7.1, RV1.2
unnamed: C8.2, R20.1
unnamed: D1.2 (A), R15.1
unnamed: D2.2 (A), R16.1
unnamed: D3.2 (A), R17.1
unnamed: J2.2, R2.2
unnamed: J5.3, R18.2
unnamed: J5.4, R19.2
unnamed: J7.3 (D+), R23.1, U6.3 (I/O2)
unnamed: J7.2 (D-), U6.1 (I/O1)
unnamed: J7.4 (ID), R25.1
unnamed: J7.6 (Shield), R24.1
unnamed: R1.1, U1.1 (Rg)
unnamed: R1.2, U1.8 (Rg)
unnamed: R4.2, R5.1, U2.4
unnamed: R9.1, RV3.1
unnamed: R10.1, RV3.3
unnamed: R11.1, RV2.2
unnamed: R12.2, R13.1, U4.1
unnamed: R13.2, RV1.1
unnamed: R22.2, SW1.2
unnamed: U1.6, U2.1 (+)
unnamed: R3.2, R4.1, U2.3 (-)
unnamed: R7.1, U3.32 (PA11)
unnamed: R8.1, U3.33 (PA12)
unnamed: C4.1, U3.3 (PC14), Y2.1
unnamed: C5.1, U3.4 (PC15), Y2.2
unnamed: C2.1, U3.5 (PD0), Y1.1
unnamed: C3.1, U3.6 (PD1), Y1.2
unnamed: C6.1, RV2.1, RV3.2, U4.3 (+), U4.5 (+)
unnamed: R11.2, R12.1, U4.2 (-)
unnamed: C7.2, R14.1, U4.6 (-)
unnamed: C21.1, R26.1, R27.2, U5.2 (GND)
PA0: J10.8, U3.10 (PA0)
PA1: J10.7, U3.11 (PA1)
PA2: J10.6, U3.12 (PA2)
PA3: J10.5, U3.13 (PA3)
PA4: J10.4, U3.14 (PA4)
PA5: J10.3, U3.15 (PA5)
PA6: J4.3, U3.16 (PA6)
PA7: J4.4, U3.17 (PA7)
PA8: J4.10, U3.29 (PA8)
PA15: J10.18, U3.38 (PA15)
PB1: J4.5, U3.19 (PB1)
PB3: J10.17, U3.39 (PB3)
PB4: J10.16, U3.40 (PB4)
PB5: J10.15, U3.41 (PB5)
PB6: J10.14, U3.42 (PB6)
PB7: J10.13, U3.43 (PB7)
PB8: J10.12, U3.45 (PB8)
PB9: J10.11, U3.46 (PB9)
PB10: J4.6, U3.21 (PB10)
PB11: J4.7, U3.22 (PB11)
PB12: J4.14, U3.25 (PB12)
PB13: J4.13, U3.26 (PB13)
PB14: J4.12, U3.27 (PB14)
PB15: J4.11, U3.28 (PB15)
PC13: D3.1 (K), U3.2 (PC13)
RESET: C20.1, R21.1, R22.1, U3.7 (NRST)
SWCLK: J6.3, U3.37 (PA14)
SWDIO: J6.2, U3.34 (PA13)
UART_RX: J9.3, U3.31 (PA10)
UART_TX: J9.2, U3.30 (PA9)
USB_D+: R8.2, U6.6 (I/O1)
USB_D-: R7.2, U6.4 (I/O2)
VBUS: C17.1, J3.1, J7.1 (VBUS), R16.2, U5.1 (VI), U6.5 (VBUS)
Vref: R2.1, R14.2, TP2.1, U1.5 (Ref), U4.7

Notes on the sheet:
Źródło napięcia referencyjnego wraz z układem generacji szumu
Wzmacniacz pomiarowy
RESET
Stabilizator napięcia 3V3
USB
SWD CONNECTOR
BOOT CONNECTOR
LED
Filtr RC, fg ≈ 318 kHz.

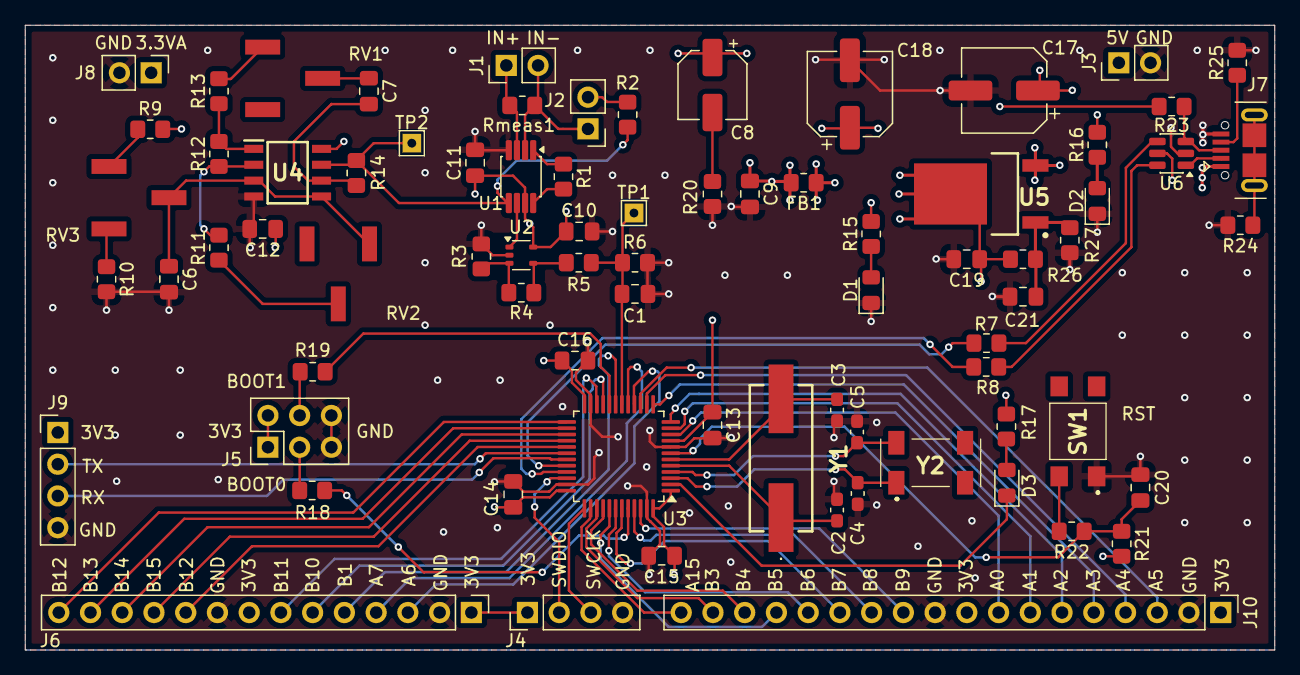
[picture p71: board AUPWSW.kicad_pcb from above]

Board: 4 copper layers, 100.0 x 50.0 mm, 77 parts (0 on the bottom side), 75 nets.
