Michalek007/CurrentSensingCircuit/Firmware/Core/Src/main.c

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
/* Includes ------------------------------------------------------------------*/
#include "main.h"

/* USER CODE BEGIN Includes */
#include "stdio.h"
/* USER CODE END Includes */

/* USER CODE BEGIN PD */

#define OVR 16
#define P 2

#define ADC_RESULT_LEN 64
#define ADC_BUF_LEN OVR*ADC_RESULT_LEN
#define UART_TX_BUF_LEN ADC_RESULT_LEN*2

/* USER CODE END PD */

ADC_HandleTypeDef hadc1;
DMA_HandleTypeDef hdma_adc1;

UART_HandleTypeDef huart1;
DMA_HandleTypeDef hdma_usart1_tx;

/* USER CODE BEGIN PV */

uint16_t adcBuffer[ADC_BUF_LEN];
//uint16_t adcResult[ADC_RESULT_LEN];
uint8_t uartTxBuffer[UART_TX_BUF_LEN];

volatile uint16_t uartTxIndex = 0;
volatile uint8_t uartTxBusy = 0;
volatile uint8_t uartTxRequest = 0;

/* USER CODE END PV */

void SystemClock_Config(void);
static void MX_GPIO_Init(void);
static void MX_DMA_Init(void);
static void MX_ADC1_Init(void);
static void MX_USART1_UART_Init(void);
/**
 * @brief  The application entry point.
 * @retval int
 */
int main(void) {
	/* MCU Configuration--------------------------------------------------------*/

	/* Reset of all peripherals, Initializes the Flash interface and the Systick. */
	HAL_Init();

	/* Configure the system clock */
	SystemClock_Config();

	/* Initialize all configured peripherals */
	MX_GPIO_Init();
	MX_DMA_Init();
	MX_ADC1_Init();
	MX_USART1_UART_Init();
	/* USER CODE BEGIN 2 */
	HAL_ADCEx_Calibration_Start(&hadc1);
	HAL_Delay(1000);
	HAL_ADC_Start_DMA(&hadc1, (uint32_t*) adcBuffer, ADC_BUF_LEN);
	/* USER CODE END 2 */

	/* Infinite loop */
	/* USER CODE BEGIN WHILE */
	while (1) {
		/* USER CODE END WHILE */

		/* USER CODE BEGIN 3 */
		if (uartTxRequest && !uartTxBusy) {
			uartTxRequest = 0;
			uartTxBusy = 1;
			HAL_UART_Transmit_DMA(&huart1, uartTxBuffer, UART_TX_BUF_LEN);
		}
	}
	/* USER CODE END 3 */
}

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
/* USER CODE BEGIN 4 */
int __io_putchar(int ch) {
	HAL_UART_Transmit(&huart1, (uint8_t*) &ch, 1, HAL_MAX_DELAY);
	return ch;
}

static inline void processAdcBlock(uint16_t *buffer, uint16_t len) {
	for (uint16_t i = 0; i < len; i += OVR) {
		uint32_t adcResultTemp = 0;
		for (uint8_t j = 0; j < OVR; ++j) {
			adcResultTemp += buffer[i + j];
		}
		adcResultTemp >>= P;
		if (uartTxIndex + 1 < UART_TX_BUF_LEN) {
			uartTxBuffer[uartTxIndex++] = adcResultTemp >> 8;
			uartTxBuffer[uartTxIndex++] = adcResultTemp;
		}
	}
	if (uartTxIndex >= UART_TX_BUF_LEN && !uartTxRequest) {
		uartTxRequest = 1;
	}
}

void HAL_ADC_ConvHalfCpltCallback(ADC_HandleTypeDef *hadc) {
	if (hadc->Instance == ADC1) {
		processAdcBlock(&adcBuffer[0], ADC_BUF_LEN / 2);
	}
}

void HAL_ADC_ConvCpltCallback(ADC_HandleTypeDef *hadc) {
	if (hadc->Instance == ADC1) {
		processAdcBlock(&adcBuffer[ADC_BUF_LEN / 2], ADC_BUF_LEN / 2);
	}
}

void HAL_UART_TxCpltCallback(UART_HandleTypeDef *huart) {
	if (huart->Instance == USART1) {
		uartTxBusy = 0;
		uartTxIndex = 0;
	}
}

/* USER CODE END 4 */
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
