Michalek007/CurrentSensingCircuit/Firmware/CurrentSensingCircuit.ioc

Mcu.UserName=STM32F103C8Tx
PA10.Signal=USART1_RX
PA9.Signal=USART1_TX
PB0.Signal=ADCx_IN8
PD0-OSC_IN.Signal=RCC_OSC_IN
PD1-OSC_OUT.Signal=RCC_OSC_OUT
