Michalek007/CurrentSensingCircuit/(commit log)

2025-10-27 Added: schematic of PSU
2025-11-11 schematics and doc update
2025-11-11 Add KiCad files
    TEST
    [AUPWSW.kicad_pcb, AUPWSW.kicad_sch]
2025-11-11 KICAD update
    [AUPWSW.kicad_sch]
2025-11-15 schematic update
    pending for team review
    [AUPWSW.kicad_sch]
2025-11-16 added some comments to schematic
    [AUPWSW.kicad_sch]
2025-11-17 Added comments to schematic
    [AUPWSW.kicad_sch]
2025-11-17 schematic update
    team review
    [AUPWSW.kicad_sch]
2025-11-24 Schematic update
    [AUPWSW.kicad_sch]
2025-11-24 tsv992 footprint
2025-11-24 ferrite simulation and schematic update
    [AUPWSW.kicad_sch]
2025-11-25 Updated schematic, added footprints and custom lib
    [AUPWSW.kicad_sch]
2025-11-25 led doc update
2025-11-27 Updated PCB layout
    [AUPWSW.kicad_pcb, AUPWSW.kicad_sch]
2025-11-29 Arranged components on PCB
    [AUPWSW.kicad_pcb, AUPWSW.kicad_sch]
2025-11-29 Updated: pcb and schematic
    [AUPWSW.kicad_pcb, AUPWSW.kicad_sch]
2025-11-30 Updated: D+ and D- routing
    [AUPWSW.kicad_pcb]
2025-12-01 Added pins names on silkscreen layer
    [AUPWSW.kicad_pcb]
2025-12-05 Updated pcb: added VBUS plane and more connectors + modified USB routing (D+ and D-)
    [AUPWSW.kicad_pcb, AUPWSW.kicad_sch]
2025-12-06 Added gnd pours on top and bottom layers
    [AUPWSW.kicad_pcb]
2025-12-07 PCB routing update, moved LSE to top layer
    [AUPWSW.kicad_pcb]
2025-12-08 PCB final
    [AUPWSW.kicad_pcb, AUPWSW.kicad_sch]
2025-12-08 Added gerbers
    [AUPWSW-B_Cu.gbr, AUPWSW-B_Mask.gbr, AUPWSW-B_Paste.gbr, AUPWSW-B_Silkscreen.gbr, AUPWSW-Edge_Cuts.gbr, AUPWSW-F_Cu.gbr, AUPWSW-F_Mask.gbr, AUPWSW-F_Paste.gbr]
2025-12-16 added BOM and links to shops
    [AUPWSW.csv, AUPWSW.kicad_sch]
2026-02-08 Updated: firmware, added: UART reading data in python
2026-02-11 Added: calibration of ADC, filtering signal with FIR in python
